tjallingk/airostation/analog-schematic.png

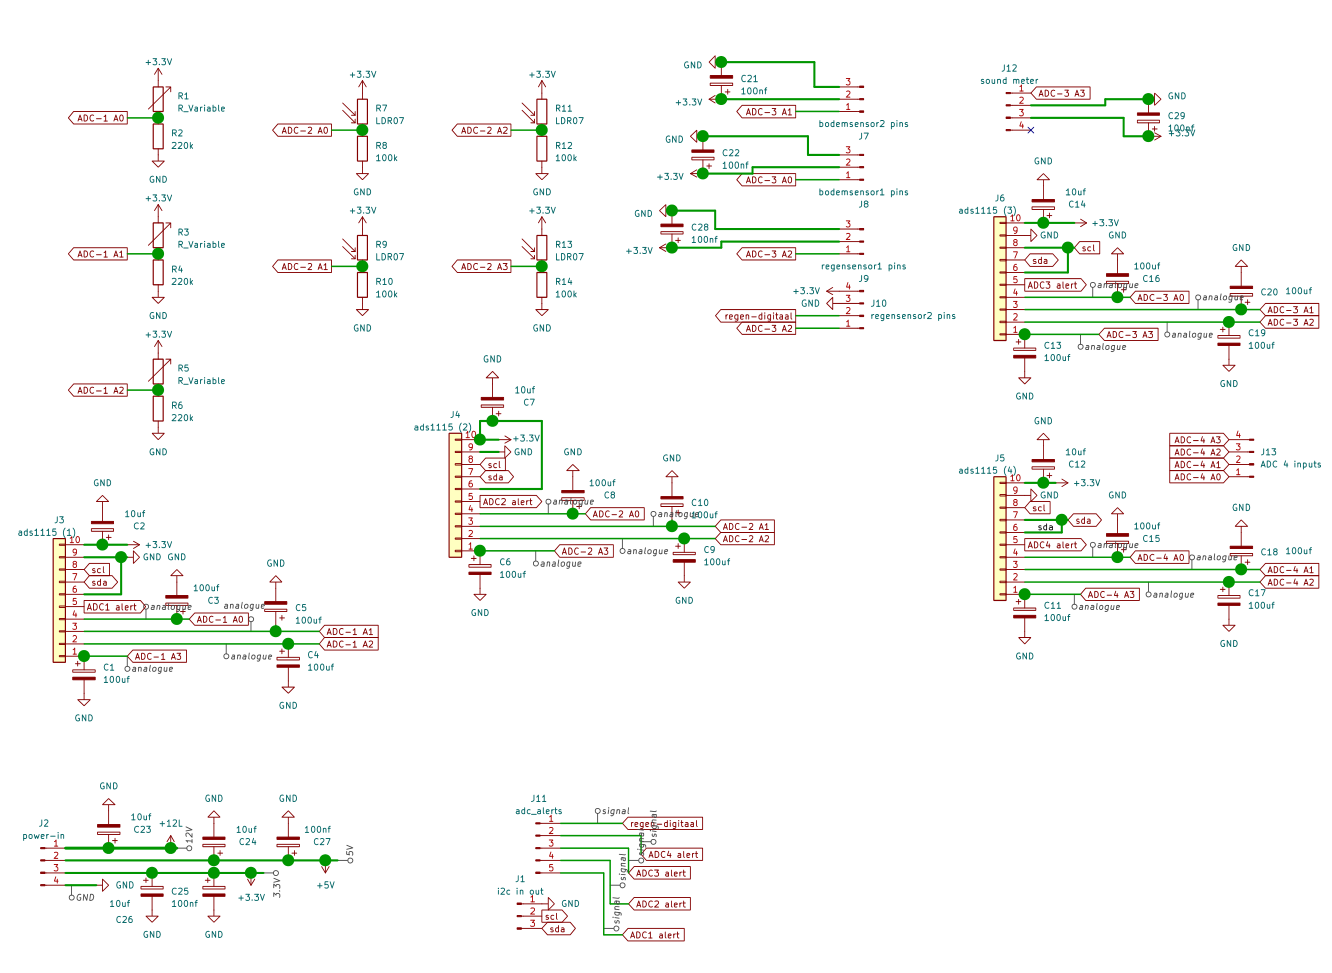
analog-schematic.png
