tjallingk/airostation/digital-main-schematic.png

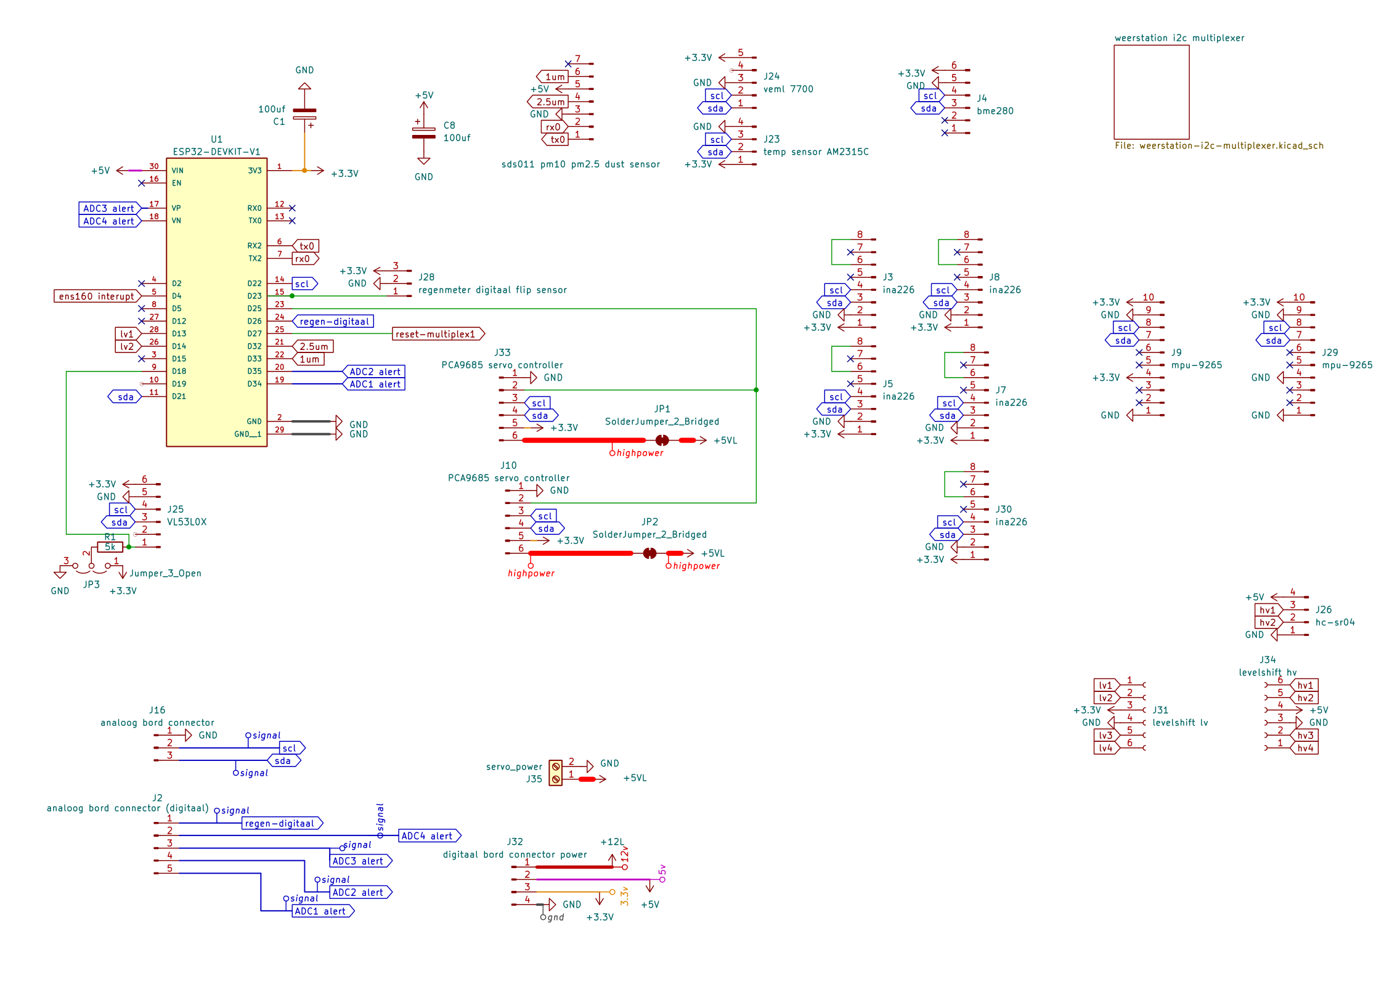
digital-main-schematic.png
