tjallingk/airostation/multiplexer-powersensor-schematic.png

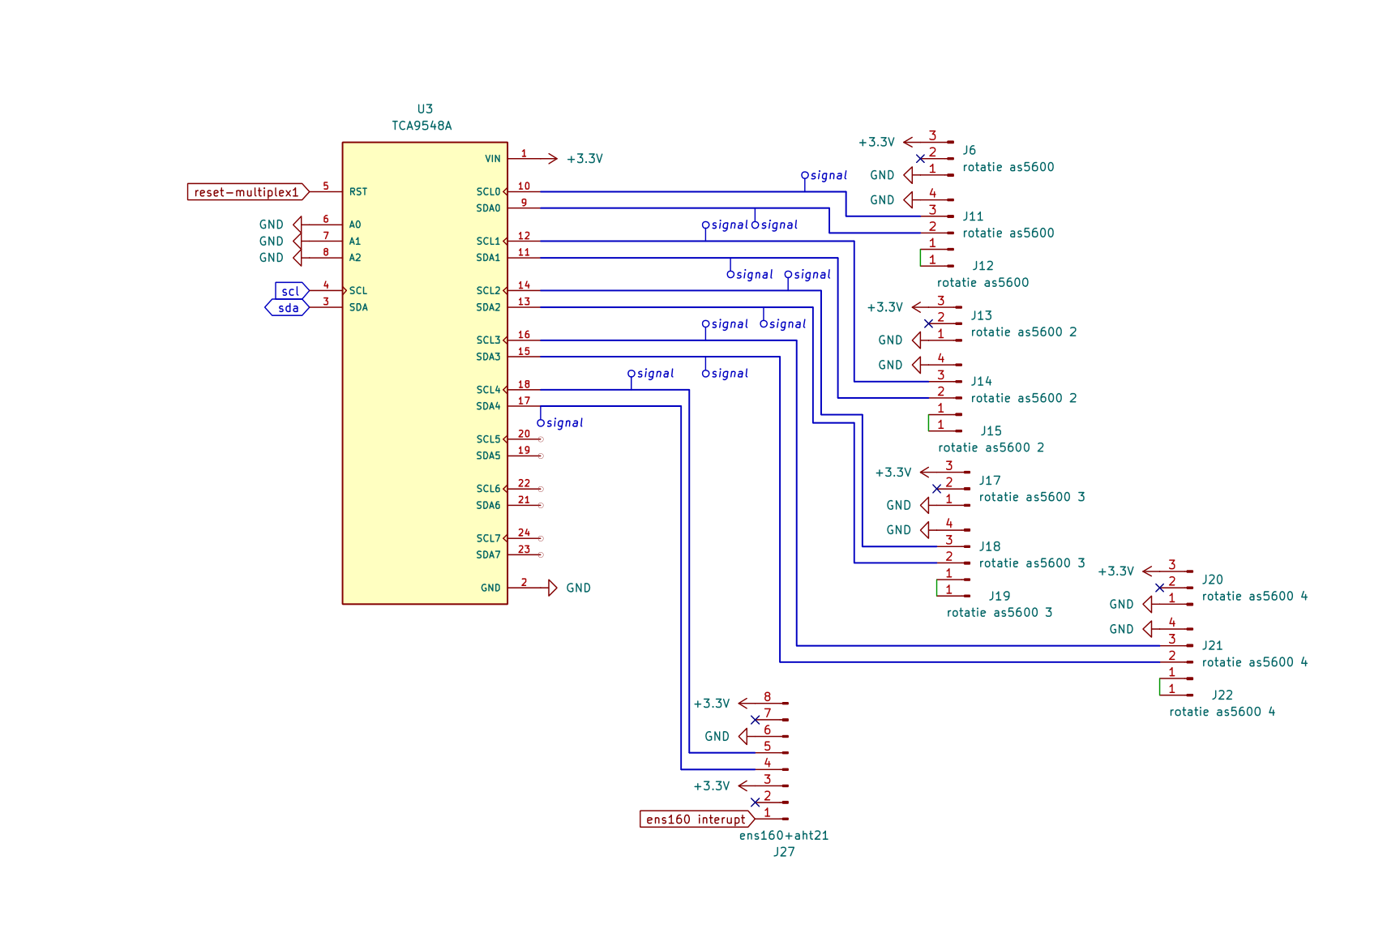
multiplexer-powersensor-schematic.png
