tjallingk/airostation/pcb images/analog-back-pcb.png

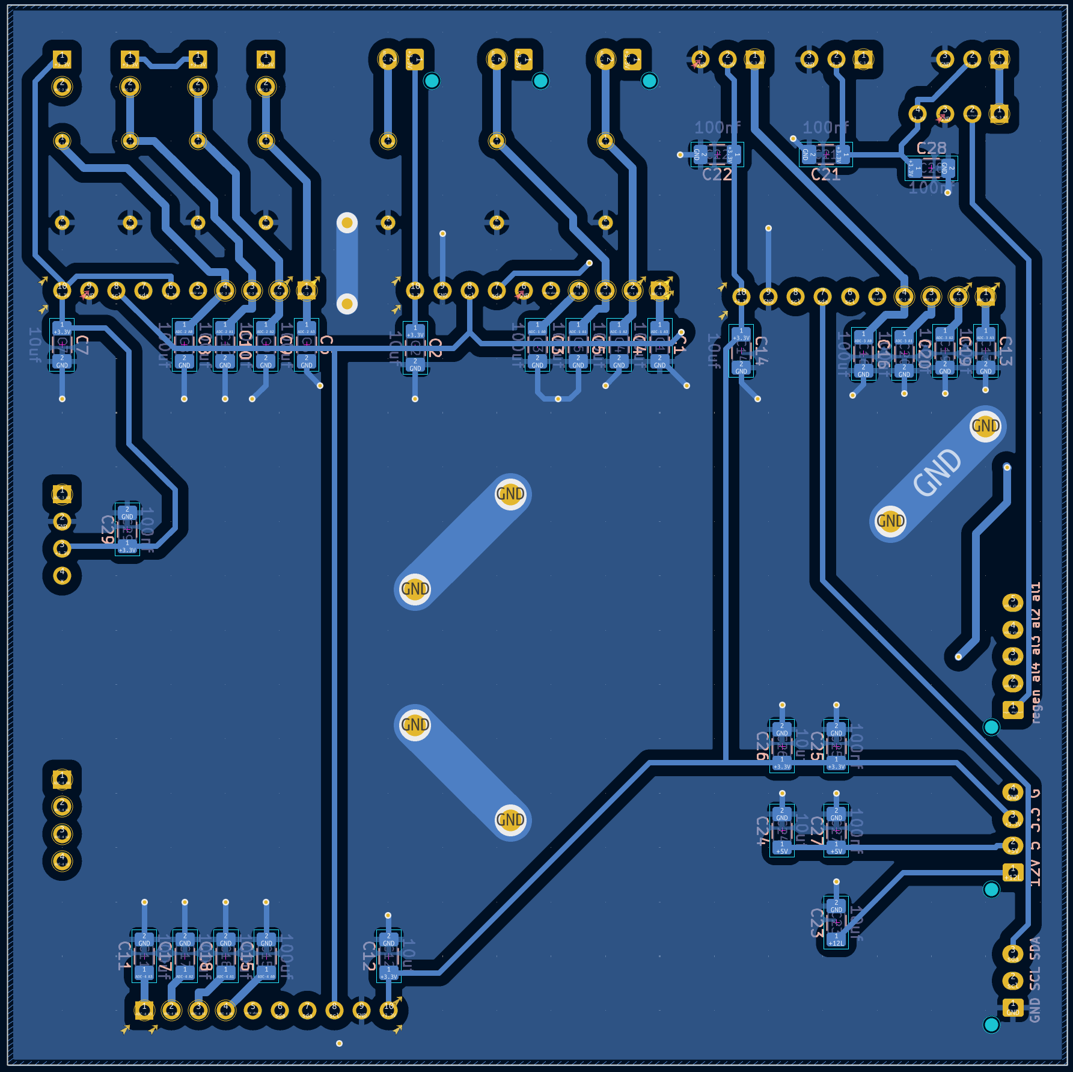
pcb images/analog-back-pcb.png
