tjallingk/airostation/pcb images/analog-front-pcb.png

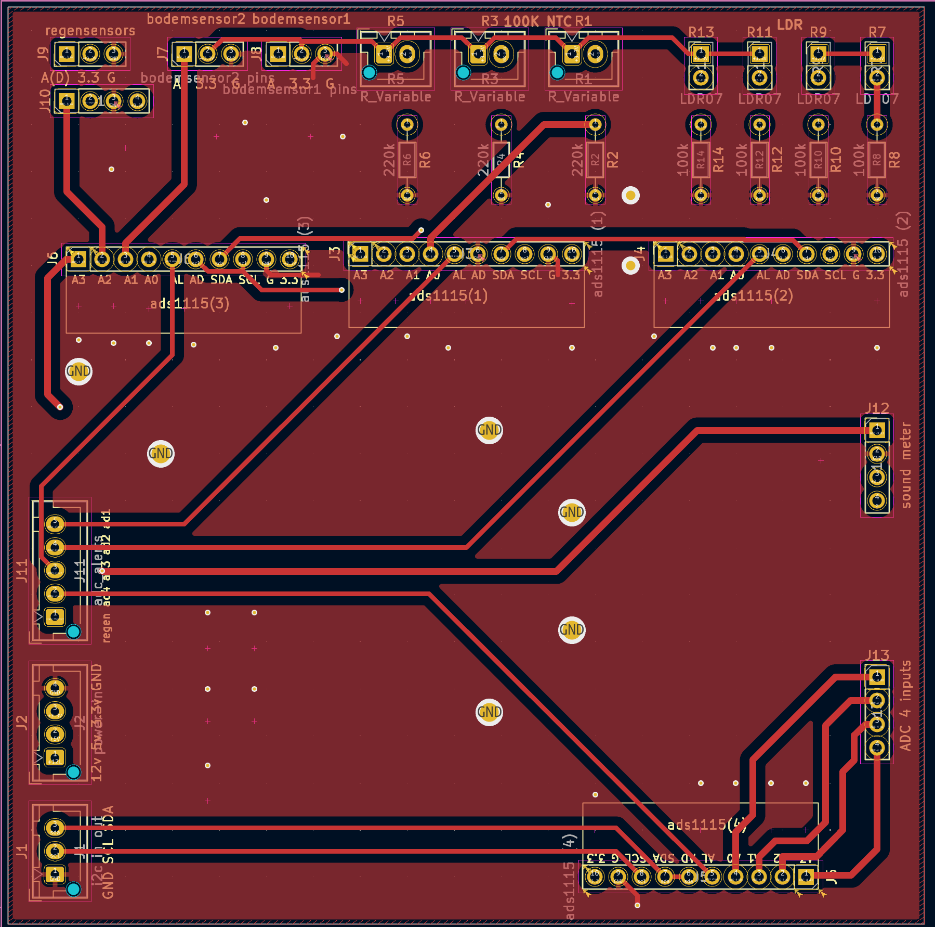
pcb images/analog-front-pcb.png
