tjallingk/airostation/pcb images/main-back-pcb.png

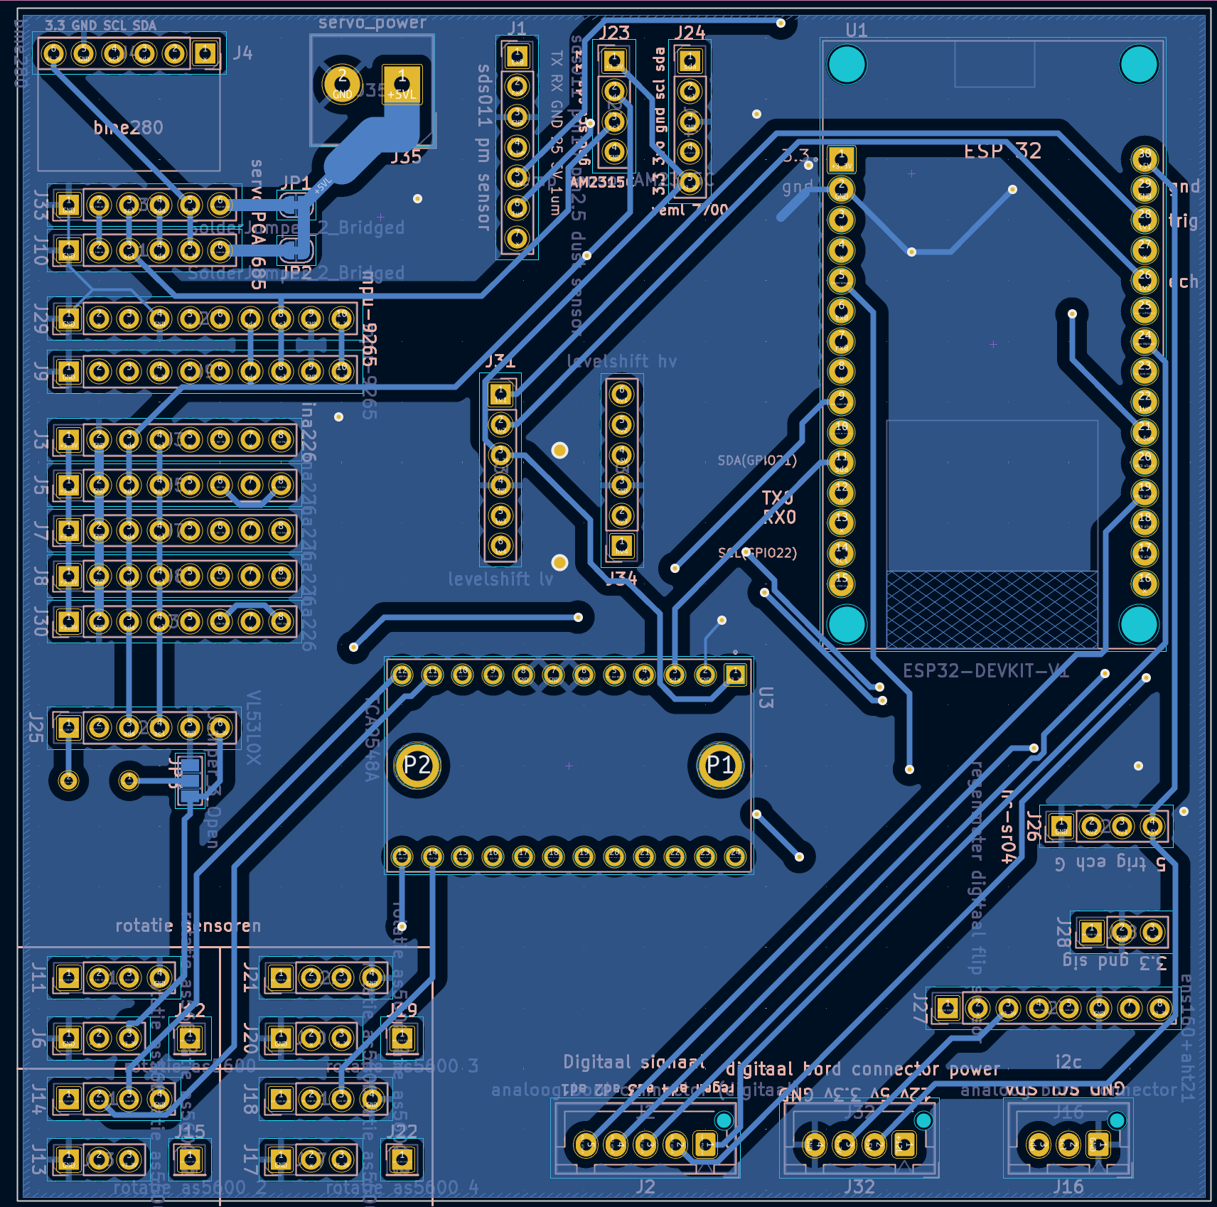
pcb images/main-back-pcb.png
