tjallingk/airostation/pcb images/main-front-pcb.png

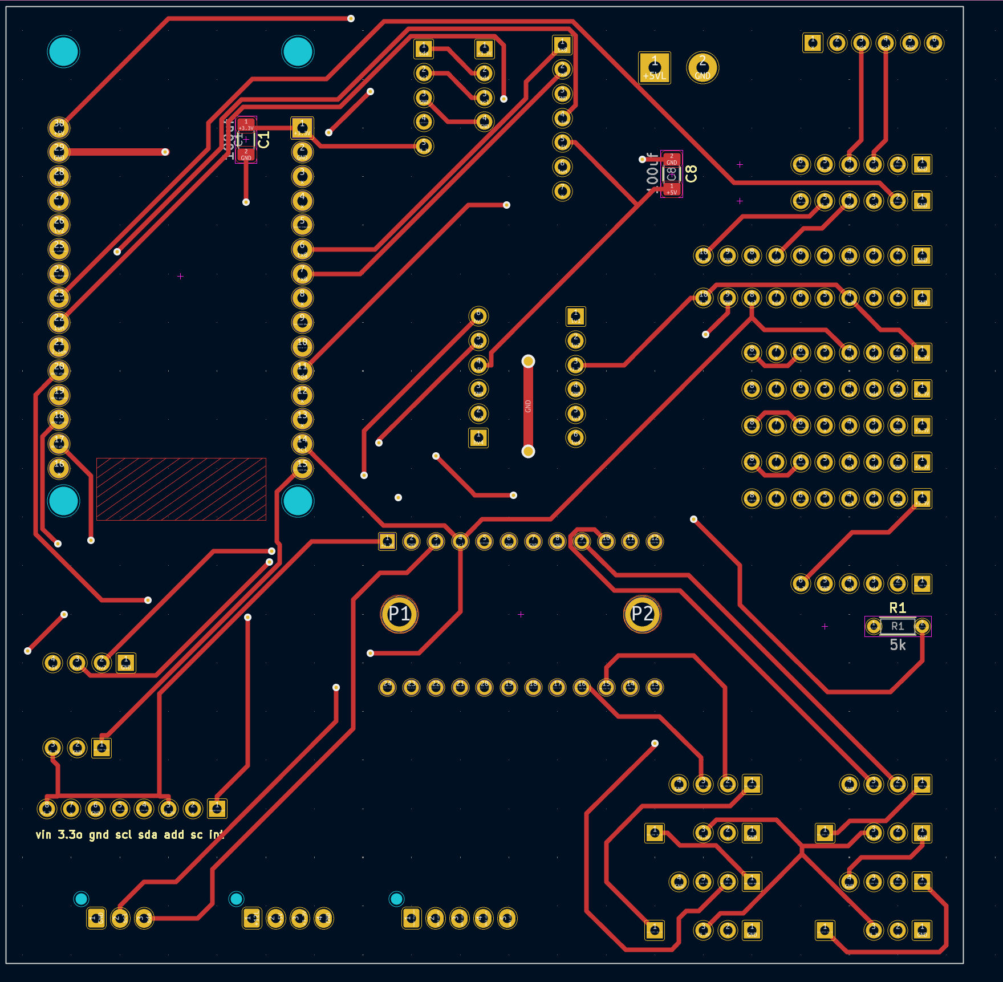
pcb images/main-front-pcb.png
