tjallingk/airostation/pcb images/power-back-pcb.png

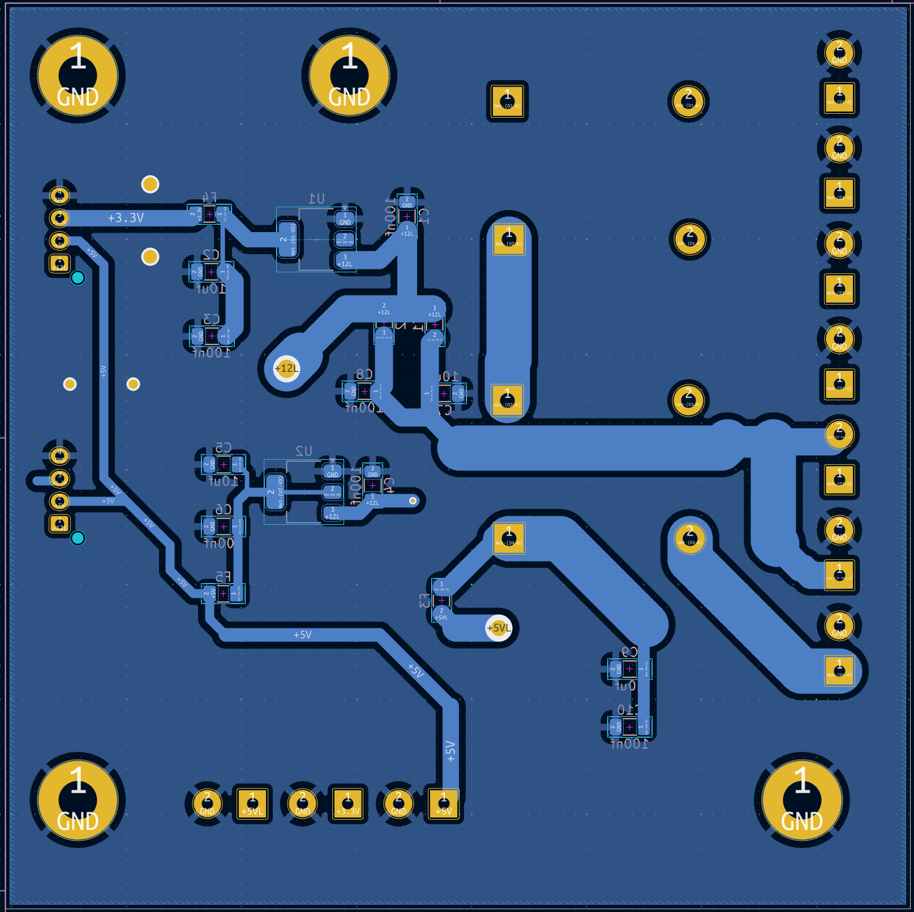
pcb images/power-back-pcb.png
