tjallingk/airostation/pcb images/power-front-pcb.png

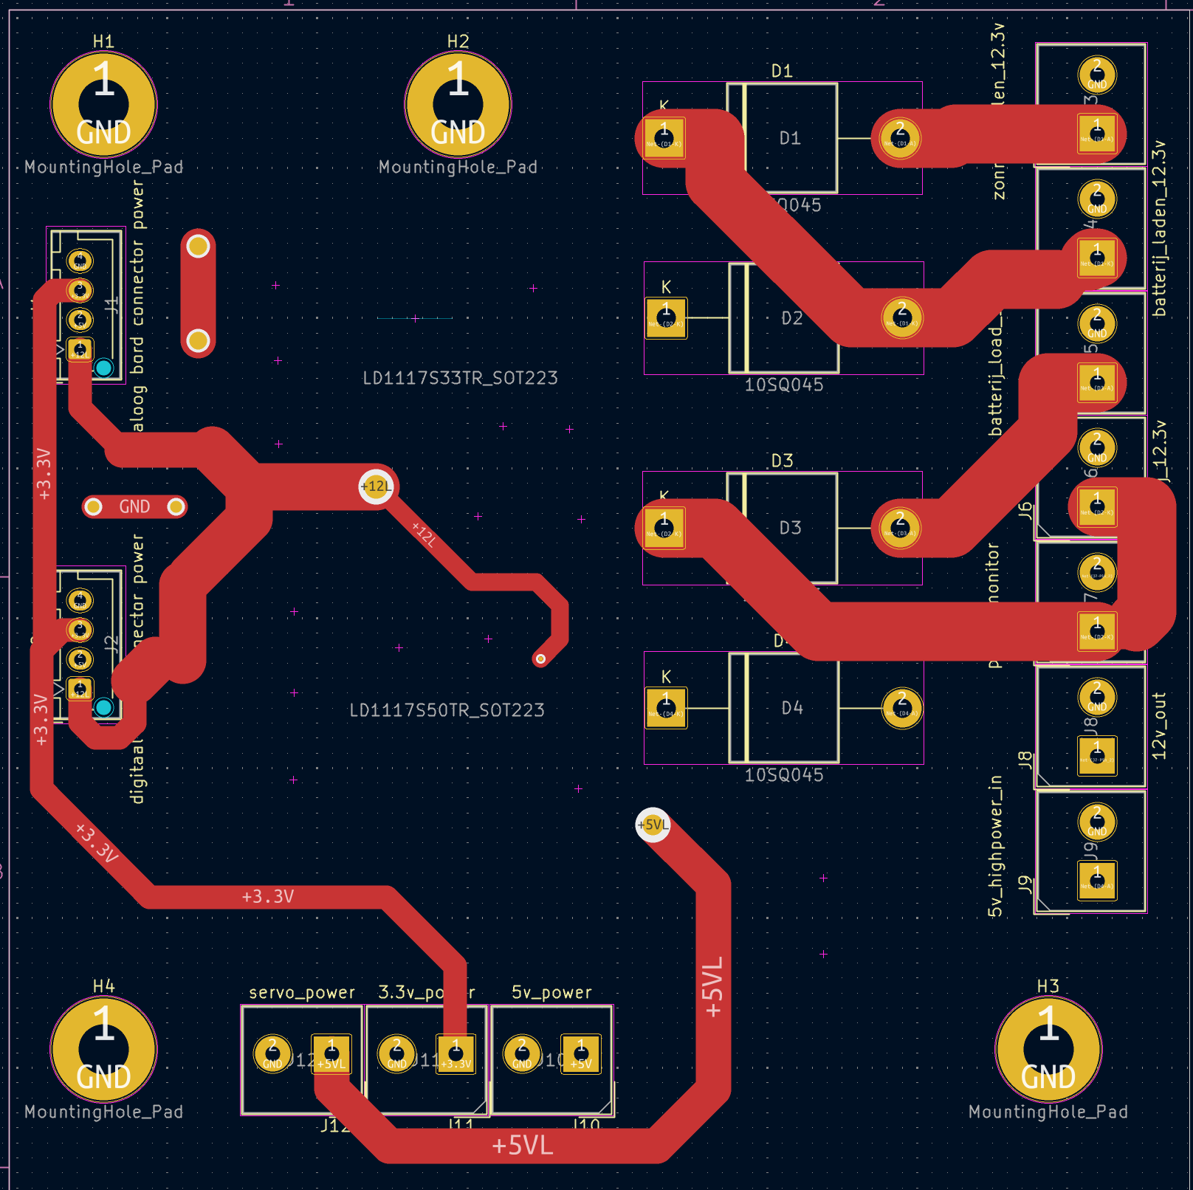
pcb images/power-front-pcb.png
