tjallingk/airostation/power-schematic.png

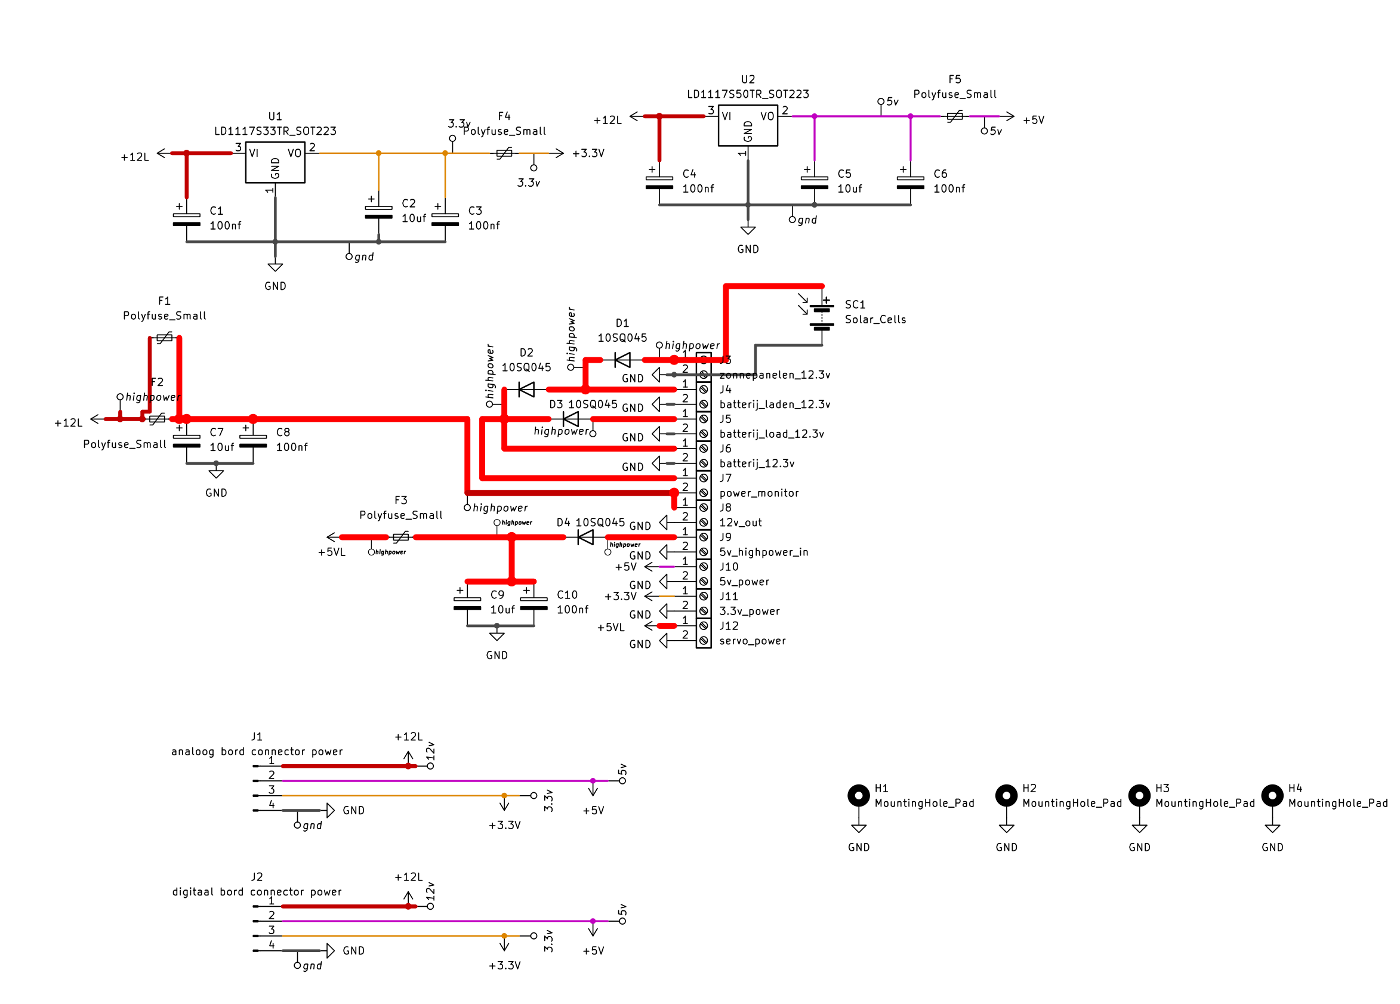
power-schematic.png
