tjallingk/airostation/pcb-files/sensoren list.ods

Components global function | part name/number | communication protocol | i2c address | function | count | importance | drawn on pcb (green is yes) | notes
power measurement | ina226 | i2c multiplexer? | 0x40,0x41,0x42,0x43,0x44,0x45,0x46,0x47,0x48,0x49, | Measure solar strength, battery charge level, and self-consumption of energy. | 5 | 3 | 6 pieces: Address is selected on the module PCB.
lux sensor | veml7700 | i2c | 0x10 | Measure the amount of sunlight. | 1 | 6
Angle sensor | mpu 9250 | i2c | 0x68,0x69 | Know the sun's position and possibly detect earthquakes? | 1 | 4 | 2 units: Only one is needed,second one possibly for earthquake detection.
Temperature sensor | AM2315C | i2c | 0x38 | Measure temperature and humidity. | 1 | 8 |  | Measured at 1.5 meters above ground level
Wind sensor | as5600 | i2c multiplexer | 0x36 | Know wind speed and direction. | 2 | 7 | 4 AS5600 | it should be measured at 10 meters high.
LDR (light-dependent resistor) | 5516 | analogue/resistor |  | Determine the sun's position along with an angle(gyro) sensor. | 4 | 4 | 4
Rain sensor |  | analogue/resistor |  | Detect rain and indicate its intensity. | 1 | 8 | 4 units, 2 types, but max 1 connected at a time.
VOC sensor | Ens160 + aht21 | i2c with multiplexer | (aht21)0x38 (ens160)0x53,0x52 | Measure air quality by detecting gases. | 1 | 7
Soil temperature sensor | ntc 100k | analogue/resistor |  | Detect ground frost and determine its depth with multiple sensors. | 3 | 6 |  | The standard depths for soil temperature measurements are 5, 10, 20, 50, and 100 cm below the surface.
Air pressure sensor | bme280 | i2c | 0x76,0x77 | Measure air pressure for weather forecasting. | 1 | 8 | Directly on the PCB. | Should be measured at mean sea level (MSL), but since that's not possible, adjustments need to be made.
Rain gauge | A3144 | digital tipping sensor |  | Measure rainfall intensity. With tipping bucket and magnet | 1 | 7
Soil moisture sensor |  | analogue |  | Measure soil moisture to determine if irrigation is needed. | 3 | 9 | 3 pieces for different places to measure the capacitive
Fine Particle sensor | sds011 | uart |  | Measure the number of fine dust particles(pm10/pm2.5) in the air. And therefor quality of air. | 1 | 7
Small solar panel |  | power short it to read |  | Measure sunlight intensity in W/m² for a panel with a surface area of 54×54 mm. | 1 | 5
Servo controller | PCA9685 | i2c | 0x40-0x7F | Control servos using fewer connectors, max 16 servos managed by 4 wires trough i2c. | 1 | 5
Distance sensor | VL53L0X | i2c | 0x52 | Snow height sensor light | 1 | 3
Distance sensor | hc sr04 | digital |  | Snow height sensor ultrasonic | 1 | 3
 |  |  |  |  | 29
ADC | ads1115 | i2c | 0x48,0x49,0x4A,0x4B | Improve measurement of analog signals with more bits. | 4 | 10
Buck converter | lm2596s |  |  | Convert 22V from the solar panel to 12V, and to 5V for servos. | 2 | 10
LDO | ld1117 |  |  | Create 5V from 12V for ESP (microcontroller). |  | 10
Servo | sg90 | pwm |  | solar tracker movement. is managed by servo controller. | 2 | 5 | The servo controller has space for 16 units.
Large solar panel |  |  |  | for off grid power with battery | 2 | 10
I2C multiplexer | TCA9548A | i2c | 0x70 tot 0x77 | Use multiple I2C sensors with the same address (e.g., AS5600). | 1 | 10
battery for backup power |  |  |  | backup for power while dark or not enough sun
bms for backup |  |  |  | backup for power while dark or not enough sun
esp32 dev board |  |  |  | controlling the whole stuff
