tjallingk/airostation/pcb-files/schematic main1.pdf

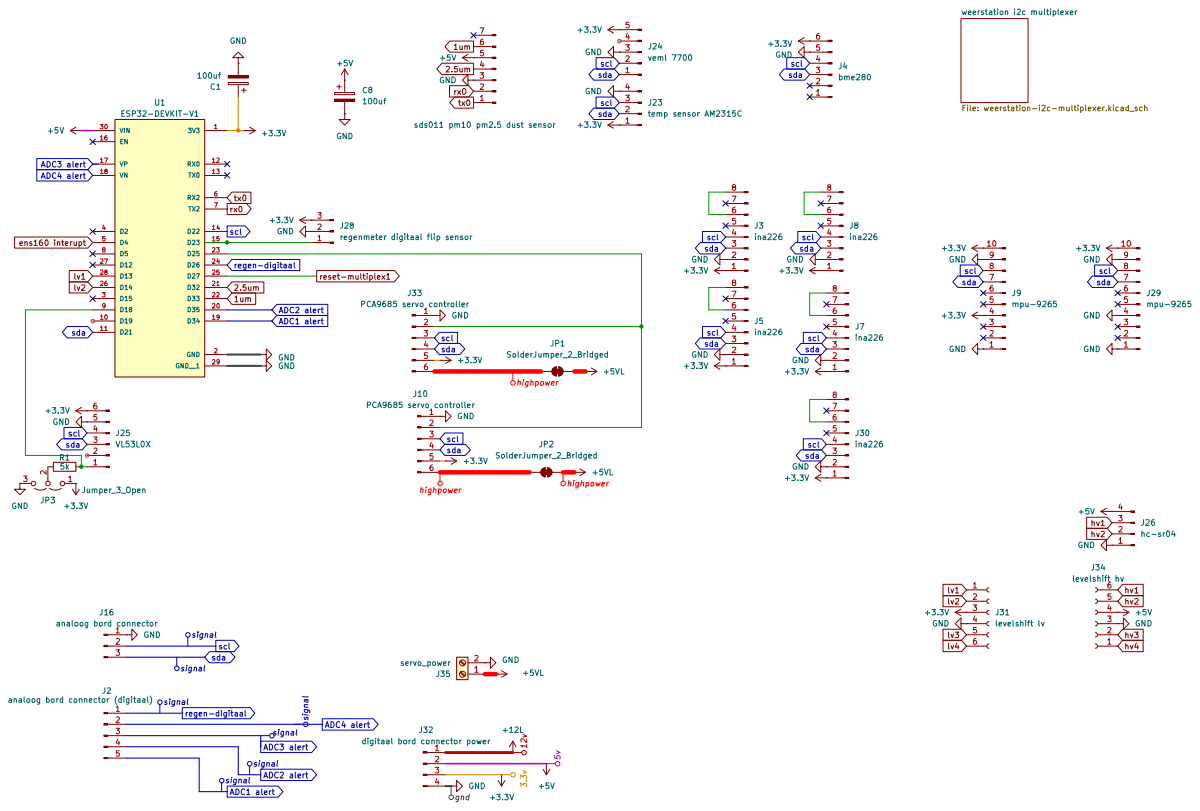
[picture p11: page 1]

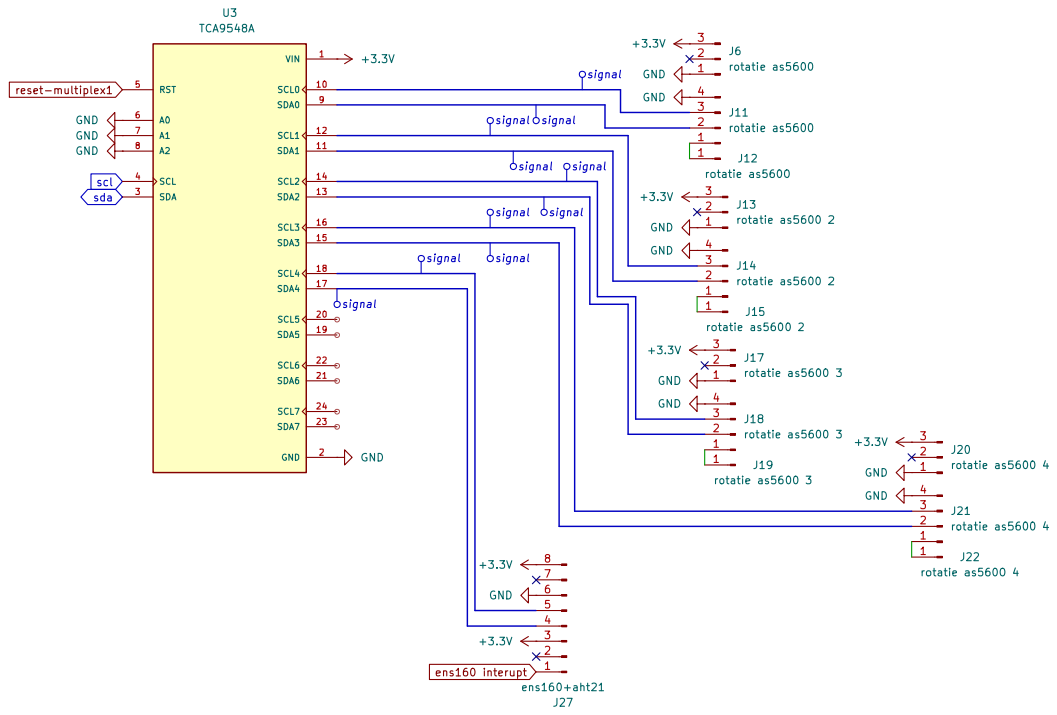
[picture p12: page 2]
