tjallingk/airostation/pcb-files/analog/schematic-analouge.pdf

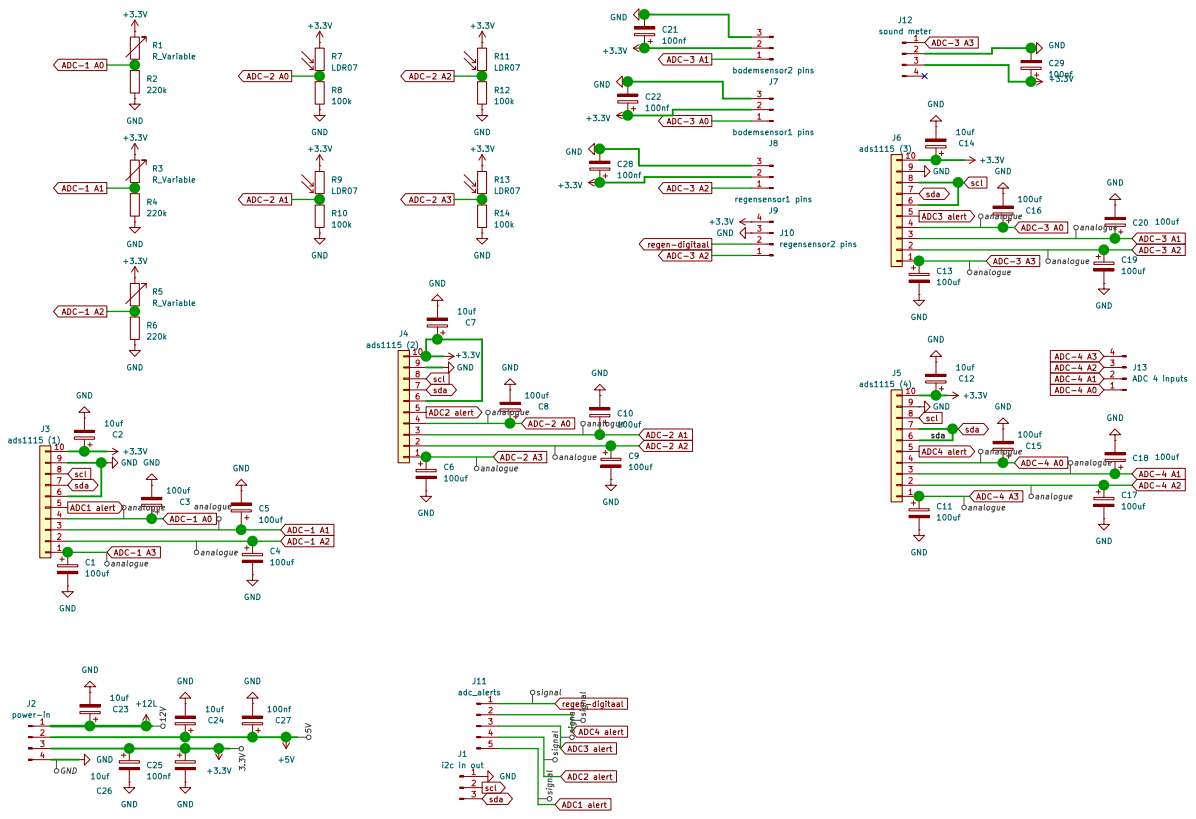
[picture p13: page 1]
