tjallingk/airostation/pcb-files/power/schematic-power.pdf

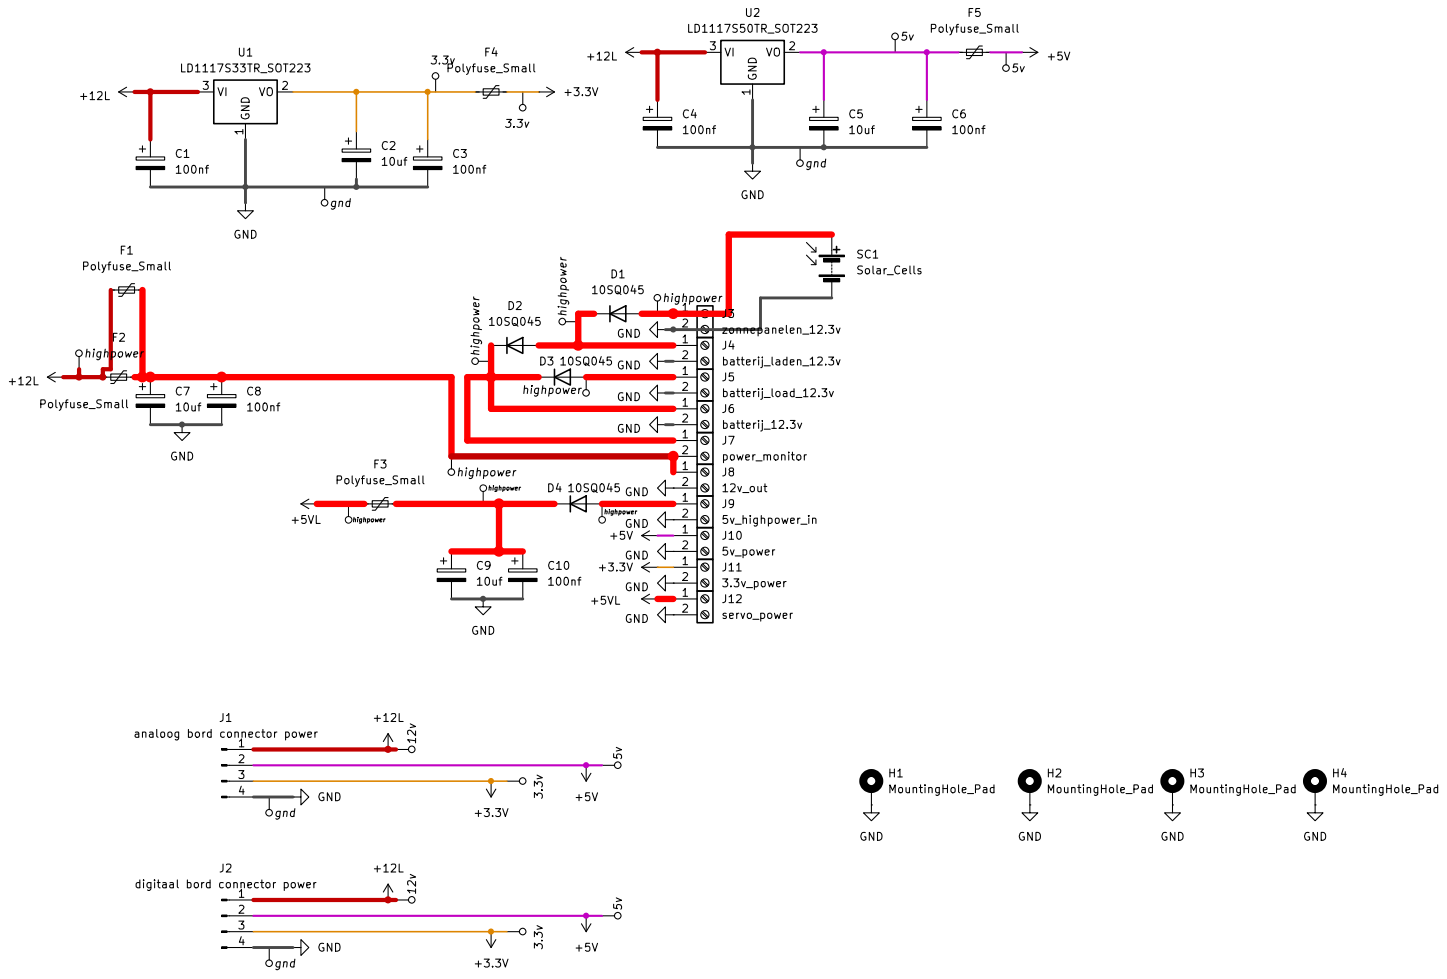
[picture p14: page 1]
