tjallingk/airostation/pcb-files/power/weerstation-power.kicad_pcb

## KiCad design pcb-files/power/weerstation-power.kicad_pcb (2024-11-19)

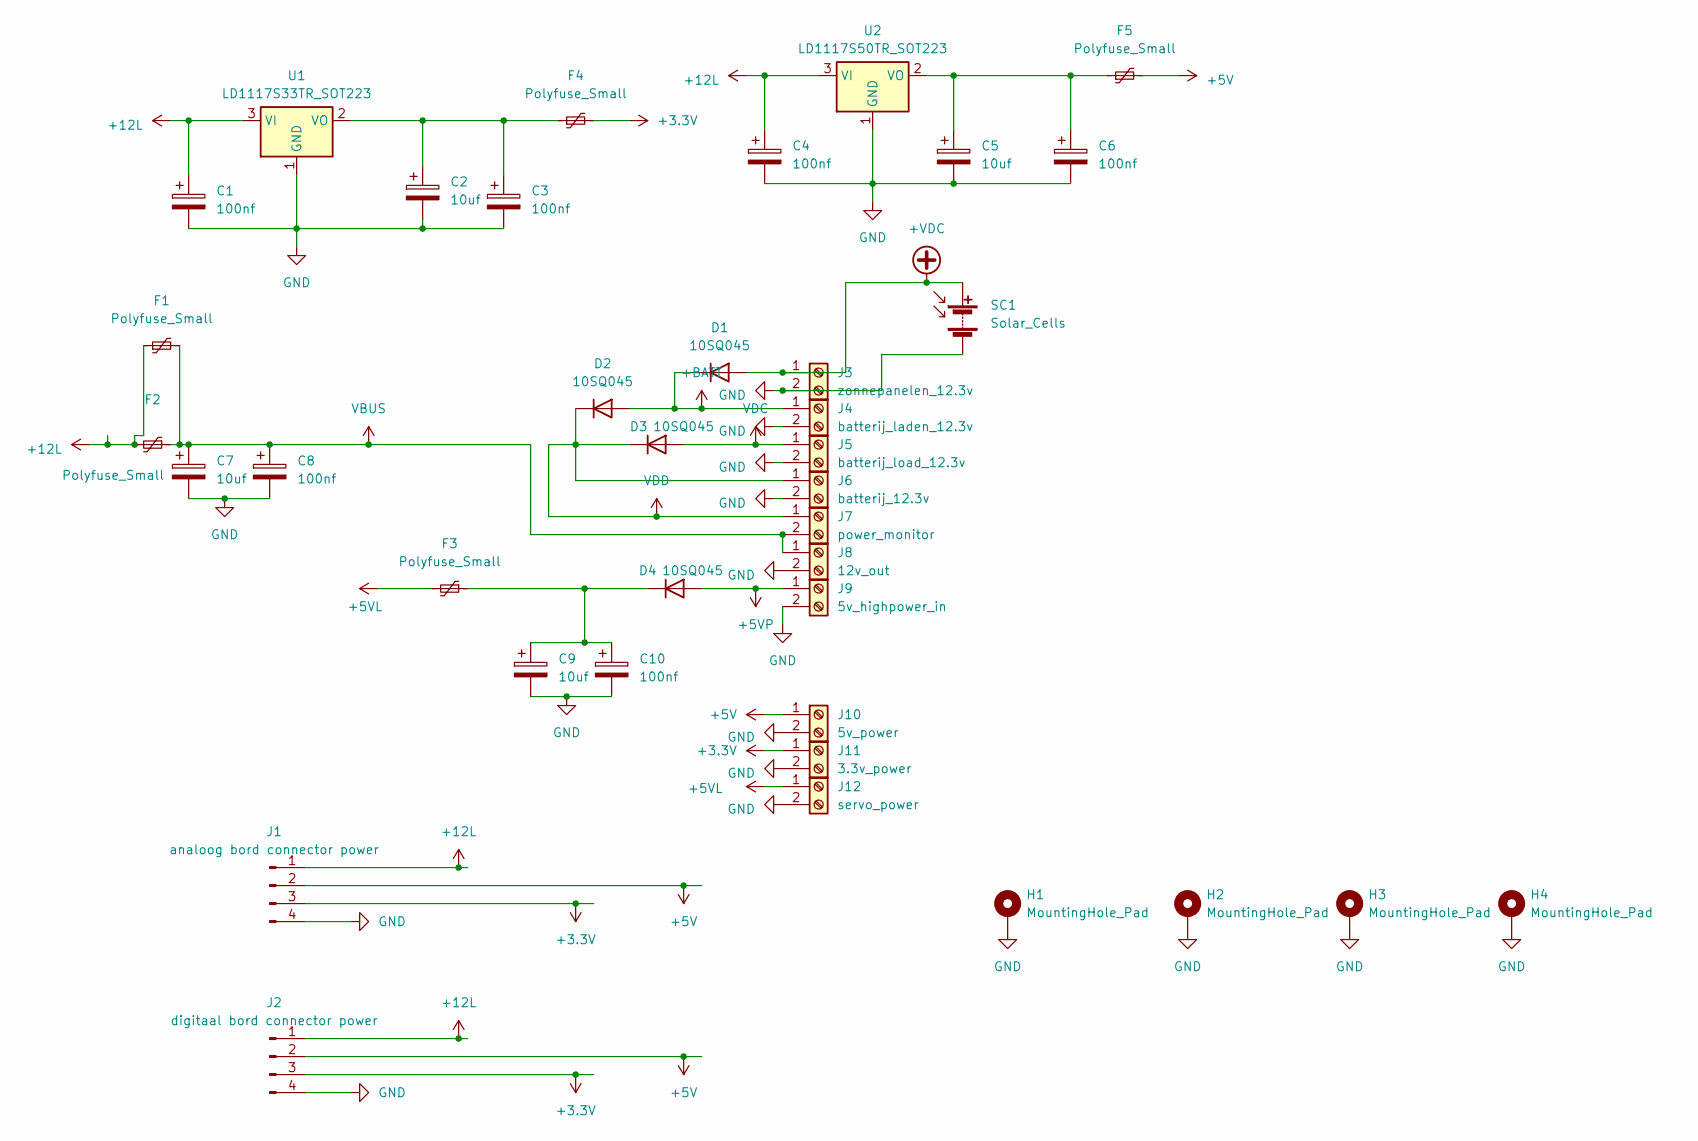
[picture p15: schematic weerstation-power.kicad_sch]

Parts:
C1, C3, C4, C6, C8, C10: 100nf; C_1206_3216Metric_Pad1.33x1.80mm_HandSolder
C2, C5, C7, C9: 10uf; C_1206_3216Metric_Pad1.33x1.80mm_HandSolder
D1, D2, D3, D4: 10SQ045; D_P600_R-6_P20.00mm_Horizontal
F1, F2, F3, F4, F5: Polyfuse_Small; Fuse_12060hole_3216Metric_Pad1.42x1.75mm_HandSolder
H1, H2, H3, H4: MountingHole_Pad; MountingHole_4.3mm_M4_Pad
J1: analoog bord connector power; JST_XH_B4B-XH-AM_1x04_P2.50mm_Vertical
J2: digitaal bord connector power; JST_XH_B4B-XH-AM_1x04_P2.50mm_Vertical
J3: zonnepanelen_12.3v; Altech_AK100_1x02_P5.00mm
J4: batterij_laden_12.3v; Altech_AK100_1x02_P5.00mm
J5: batterij_load_12.3v; Altech_AK100_1x02_P5.00mm
J6: batterij_12.3v; Altech_AK100_1x02_P5.00mm
J7: power_monitor; Altech_AK100_1x02_P5.00mm
J8: 12v_out; Altech_AK100_1x02_P5.00mm
J9: 5v_highpower_in; Altech_AK100_1x02_P5.00mm
J10: 5v_power; Altech_AK100_1x02_P5.00mm
J11: 3.3v_power; Altech_AK100_1x02_P5.00mm
J12: servo_power; Altech_AK100_1x02_P5.00mm
SC1: Solar_Cells
U1: LD1117S33TR_SOT223; SOT-223-3_TabPin2
U2: LD1117S50TR_SOT223; SOT-223-3_TabPin2

Connections:
+3.3V: F4.2, J1.3, J2.3, J11.1
+5V: F5.2, J1.2, J2.2, J10.1
+5VL: F3.2, J12.1
+5VP: D4.2 (A), J9.1
+12L: C1.1, C4.1, F1.1, F2.2, J1.1, J2.1, U1.3 (VI), U2.3 (VI)
+BATT: D1.1 (K), D2.2 (A), J4.1
+VDC: D1.2 (A), J3.1, SC1.1 (+)
GND: C1.2, C2.2, C3.2, C4.2, C5.2, C6.2, C7.2, C8.2, C9.2, C10.2, H1.1, H2.1, H3.1, H4.1, J1.4, J2.4, J3.2, J4.2, J5.2, J6.2, J8.2, J9.2, J10.2, J11.2, J12.2, SC1.2 (-), U1.1 (GND), U2.1 (GND)
unnamed: C9.1, C10.1, D4.1 (K), F3.1
unnamed: C2.1, C3.1, F4.1, U1.2 (VO)
unnamed: C5.1, C6.1, F5.1, U2.2 (VO)
VBUS: C7.1, C8.1, F1.2, F2.1, J7.2, J8.1
VDC: D3.2 (A), J5.1
VDD: D2.1 (K), D3.1 (K), J6.1, J7.1

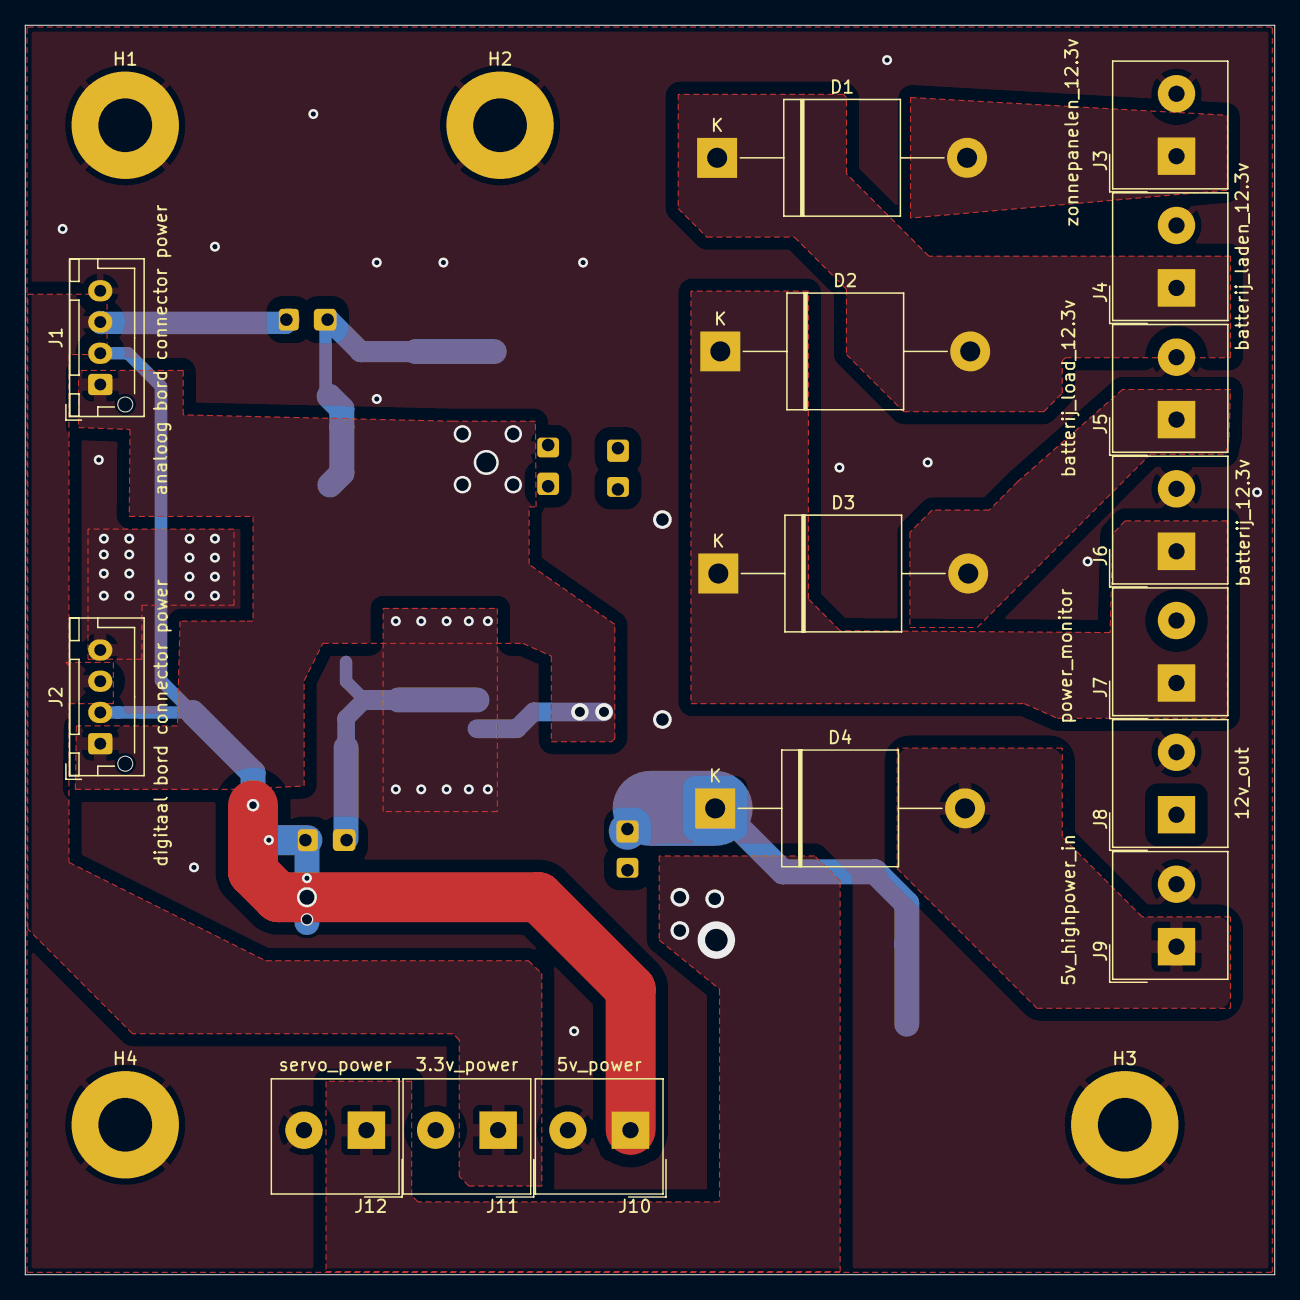
[picture p16: board weerstation-power.kicad_pcb from above]

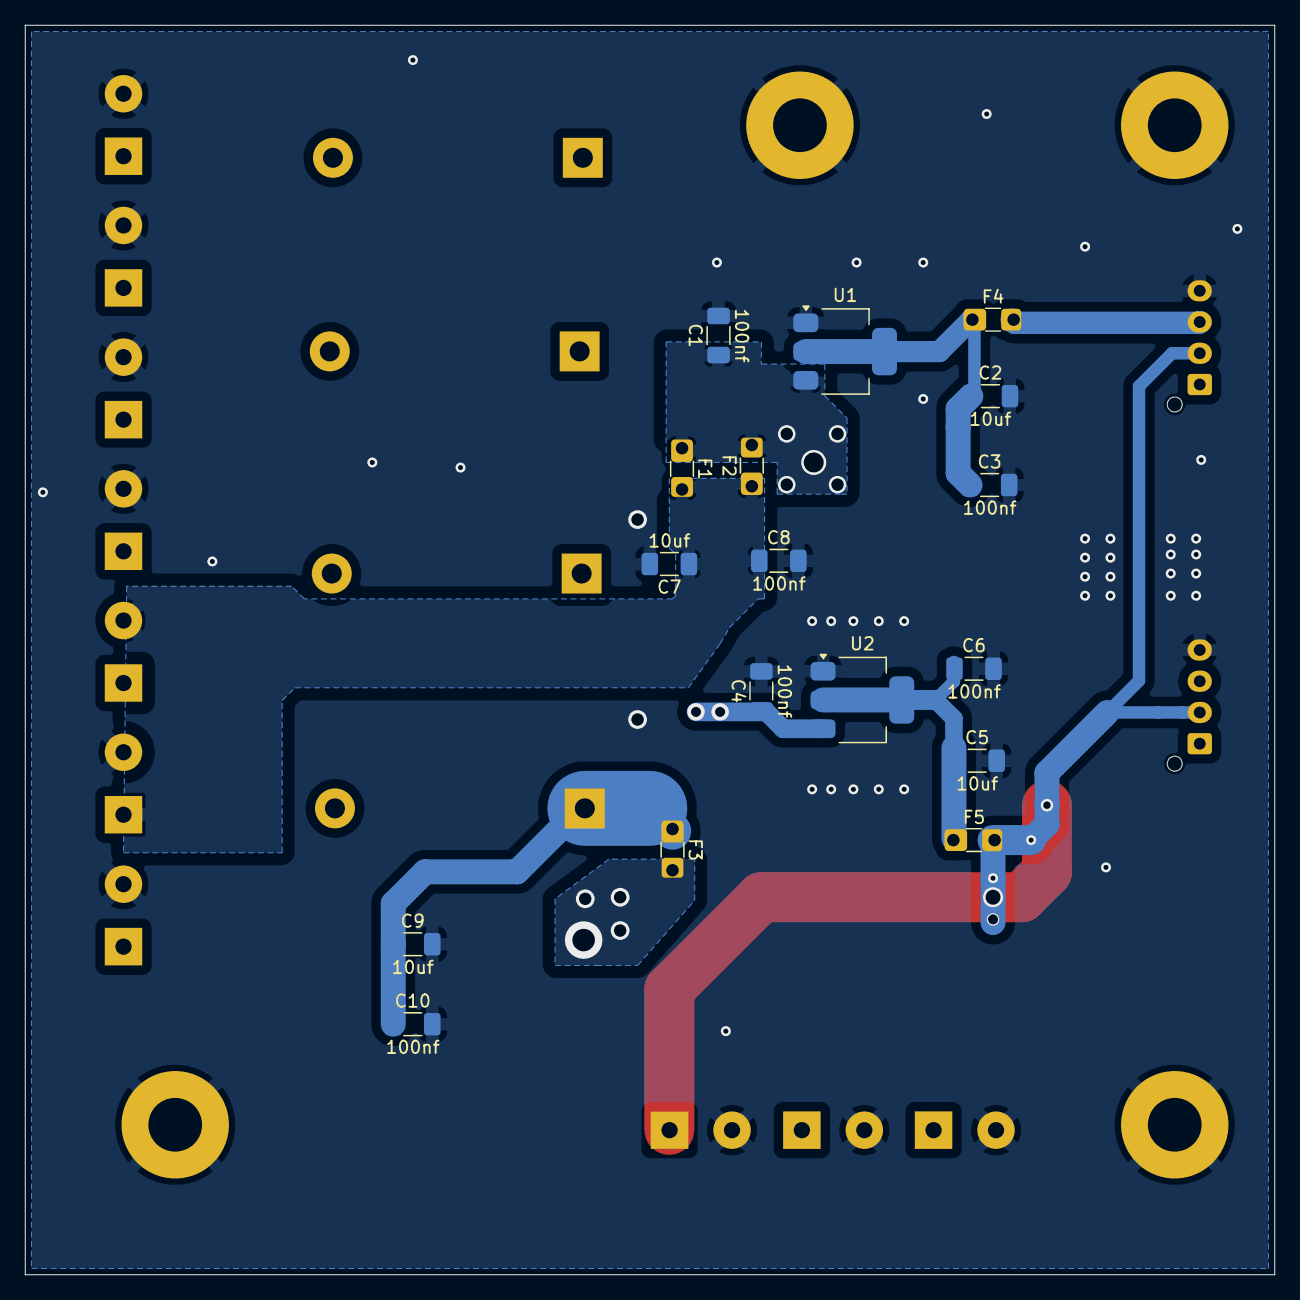
[picture p17: board weerstation-power.kicad_pcb from below]

Board: 2 copper layers, 100.0 x 100.0 mm, 37 parts (17 on the bottom side), 14 nets.
