tjallingk/airostation/pcb-files/main-digital/weerstation-main.kicad_pcb

## KiCad design pcb-files/main-digital/weerstation-main.kicad_pcb (2024-11-19)

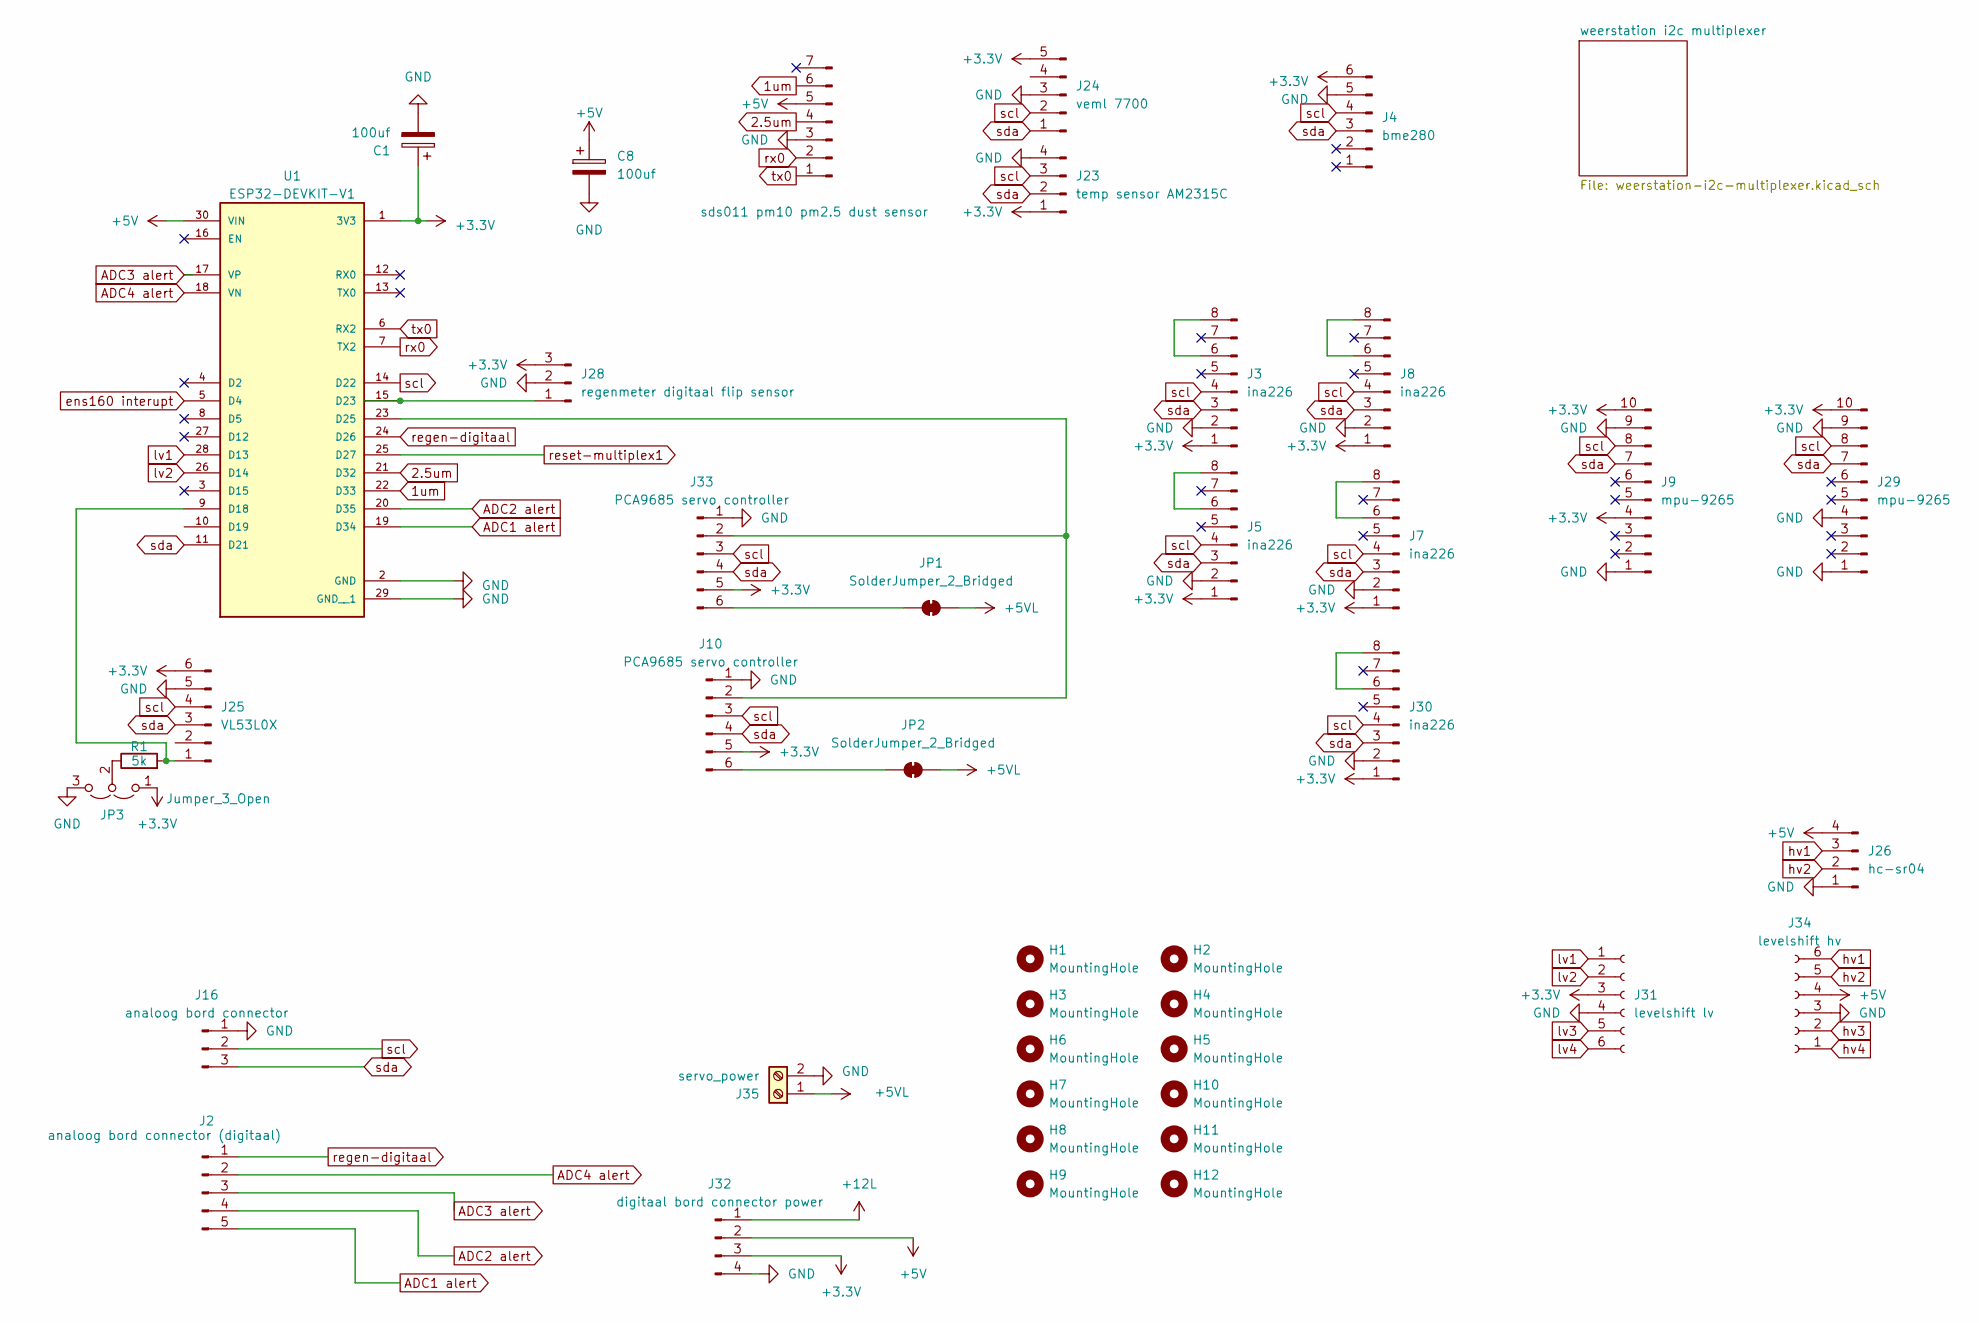
[picture p18: schematic weerstation-main.kicad_sch]

Parts:
C1, C8: 100uf; C_1206_3216Metric_Pad1.33x1.80mm_HandSolder
H1, H2, H3, H4, H5, H6, H7, H8, H9, H10, H11, H12: MountingHole; MountingHole_long
J1: sds011 pm10 pm2.5 dust sensor; PinHeader_1x07_P2.54mm_Vertical
J2: analoog bord connector (digitaal); JST_XH_B5B-XH-AM_1x05_P2.50mm_Vertical
J3, J5, J7, J8, J30: ina226; PinHeader_1x08_P2.54mm_Vertical
J4: bme280; PinSocket_1x06_P2.54mm_Vertical
J9, J29: mpu-9265; PinHeader_1x10_P2.54mm_Vertical
J10, J33: PCA9685 servo controller; PinHeader_1x06_P2.54mm_Vertical
J16: analoog bord connector; JST_XH_B3B-XH-AM_1x03_P2.50mm_Vertical
J23: temp sensor AM2315C; PinHeader_1x04_P2.54mm_Vertical
J24: veml 7700; PinHeader_1x05_P2.54mm_Vertical
J25: VL53L0X; PinSocket_1x06_P2.54mm_Vertical
J26: hc-sr04; PinHeader_1x04_P2.54mm_Vertical
J28: regenmeter digitaal flip sensor; PinHeader_1x03_P2.54mm_Vertical
J31: levelshift lv; PinSocket_1x06_P2.54mm_Vertical
J32: digitaal bord connector power; JST_XH_B4B-XH-AM_1x04_P2.50mm_Vertical
J34: levelshift hv; PinSocket_1x06_P2.54mm_Vertical
J35: servo_power; Altech_AK100_1x02_P5.00mm
JP1, JP2: SolderJumper_2_Bridged; SolderJumper-2_P1.3mm_Bridged_RoundedPad1.0x1.5mm
JP3: Jumper_3_Open; SolderJumper-3_P1.3mm_Open_Pad1.0x1.5mm
R1: 5k; R_Axial_DIN0204_L3.6mm_D1.6mm_P5.08mm_Horizontal
U1: ESP32-DEVKIT-V1; MODULE_ESP32_DEVKIT_V1; PARTREV N/A

Connections:
1um: J1.6, U1.22 (D33)
2.5um: J1.4, U1.21 (D32)
+3.3V: C1.1, J3.1, J4.6, J5.1, J7.1, J8.1, J9.4, J9.10, J10.5, J23.1, J24.5, J25.6, J28.3, J29.10, J30.1, J31.3, J32.3, J33.5, JP3.1 (A), U1.1 (3V3); also elsewhere on the board
+5V: C8.1, J1.5, J26.4, J32.2, J34.4, U1.30 (VIN)
+5VL: J35.1, JP1.2 (B), JP2.2 (B)
+12L: J32.1
ADC1 alert: J2.5, U1.19 (D34)
ADC2 alert: J2.4, U1.20 (D35)
ADC3 alert: J2.3, U1.17 (VP)
ADC4 alert: J2.2, U1.18 (VN)
GND: C1.2, C8.2, J1.3, J3.2, J4.5, J5.2, J7.2, J8.2, J9.1, J9.9, J10.1, J16.1, J23.4, J24.3, J25.5, J26.1, J28.2, J29.1, J29.4, J29.9, J30.2, J31.4, J32.4, J33.1, J34.3, J35.2, JP3.3 (B), U1.2 (GND), U1.29 (GND__1); also elsewhere on the board
unnamed: J3.6, J3.8
unnamed: J5.6, J5.8
unnamed: J7.6, J7.8
unnamed: J8.6, J8.8
unnamed: J10.2, J33.2, U1.23 (D25)
unnamed: J10.6, JP2.1 (A)
unnamed: J25.1, R1.2, U1.9 (D18)
unnamed: J28.1, U1.15 (D23)
unnamed: J30.6, J30.8
unnamed: J33.6, JP1.1 (A)
unnamed: JP3.2 (C), R1.1
ens160 interupt: U1.5 (D4); also elsewhere on the board
hv1: J26.3, J34.6
hv2: J26.2, J34.5
hv3: J34.2
hv4: J34.1
lv1: J31.1, U1.28 (D13)
lv2: J31.2, U1.26 (D14)
lv3: J31.5
lv4: J31.6
regen-digitaal: J2.1, U1.24 (D26)
reset-multiplex1: U1.25 (D27)
rx0: J1.2, U1.7 (TX2)
scl: J3.4, J4.4, J5.4, J7.4, J8.4, J9.8, J10.3, J16.2, J23.3, J24.2, J25.4, J29.8, J30.4, J33.3, U1.14 (D22); also elsewhere on the board
sda: J3.3, J4.3, J5.3, J7.3, J8.3, J9.7, J10.4, J16.3, J23.2, J24.1, J25.3, J29.7, J30.3, J33.4, U1.11 (D21); also elsewhere on the board
tx0: J1.1, U1.6 (RX2)

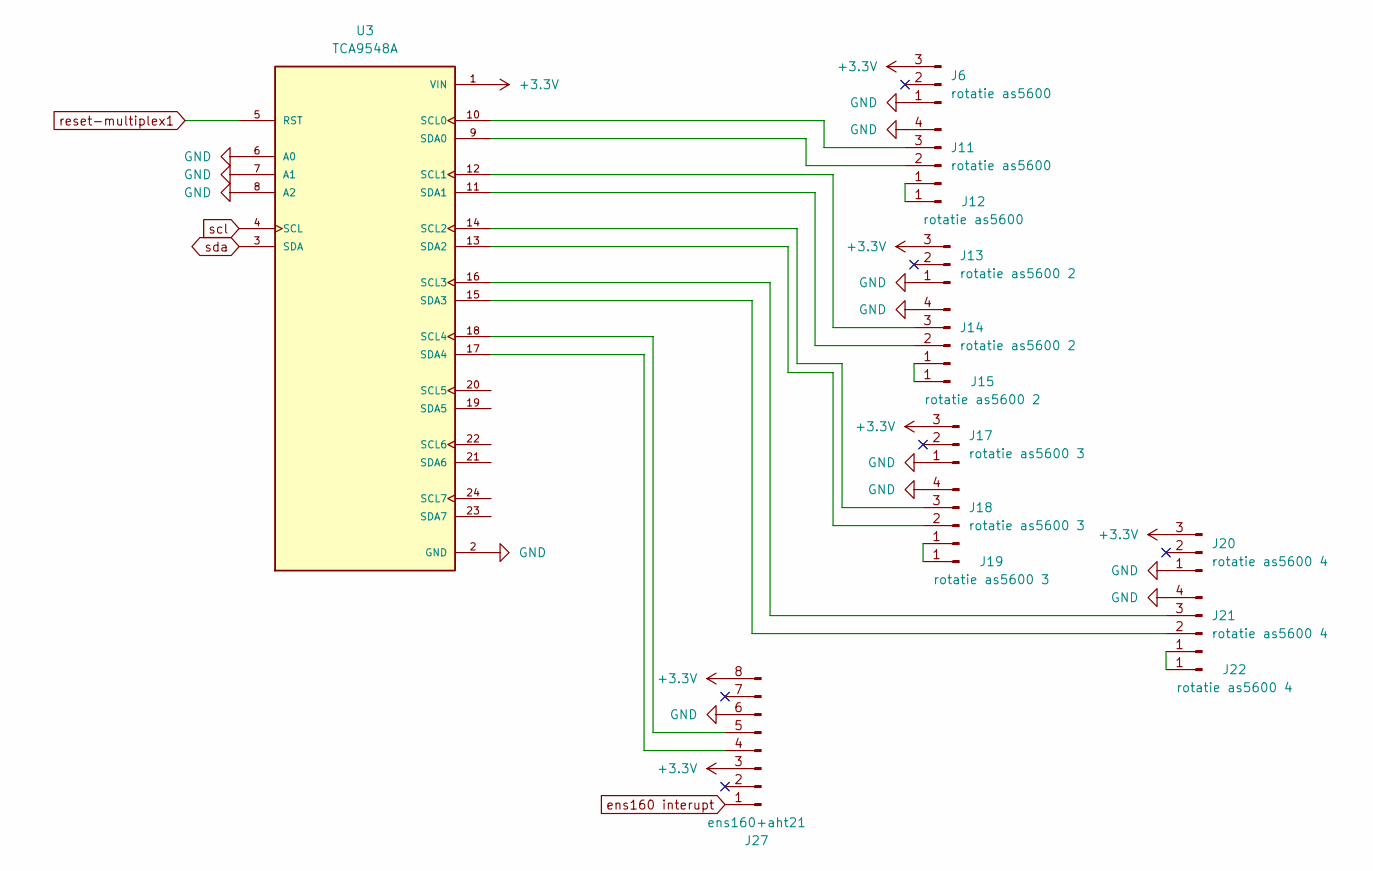
[picture p19: schematic weerstation-i2c-multiplexer.kicad_sch]

Parts:
J6: rotatie as5600; PinHeader_1x03_P2.54mm_Vertical
J11: rotatie as5600; PinHeader_1x04_P2.54mm_Vertical
J12: rotatie as5600; PinHeader_1x01_P2.54mm_Vertical
J13: rotatie as5600 2; PinHeader_1x03_P2.54mm_Vertical
J14: rotatie as5600 2; PinHeader_1x04_P2.54mm_Vertical
J15: rotatie as5600 2; PinHeader_1x01_P2.54mm_Vertical
J17: rotatie as5600 3; PinHeader_1x03_P2.54mm_Vertical
J18: rotatie as5600 3; PinHeader_1x04_P2.54mm_Vertical
J19: rotatie as5600 3; PinHeader_1x01_P2.54mm_Vertical
J20: rotatie as5600 4; PinHeader_1x03_P2.54mm_Vertical
J21: rotatie as5600 4; PinHeader_1x04_P2.54mm_Vertical
J22: rotatie as5600 4; PinHeader_1x01_P2.54mm_Vertical
J27: ens160+aht21; PinHeader_1x08_P2.54mm_Vertical
U3: TCA9548A; MODULE_2717; PARTREV Sep 11, 2015

Connections:
+3.3V: J6.3, J13.3, J17.3, J20.3, J27.3, J27.8, U3.1 (VIN); also elsewhere on the board
GND: J6.1, J11.4, J13.1, J14.4, J17.1, J18.4, J20.1, J21.4, J27.6, U3.2 (GND), U3.6 (A0), U3.7 (A1), U3.8 (A2); also elsewhere on the board
unnamed: J11.1, J12.1
unnamed: J11.2, U3.9 (SDA0)
unnamed: J11.3, U3.10 (SCL0)
unnamed: J14.1, J15.1
unnamed: J14.2, U3.11 (SDA1)
unnamed: J14.3, U3.12 (SCL1)
unnamed: J18.1, J19.1
unnamed: J18.2, U3.13 (SDA2)
unnamed: J18.3, U3.14 (SCL2)
unnamed: J21.1, J22.1
unnamed: J21.2, U3.15 (SDA3)
unnamed: J21.3, U3.16 (SCL3)
unnamed: J27.4, U3.17 (SDA4)
unnamed: J27.5, U3.18 (SCL4)
ens160 interupt: J27.1; also elsewhere on the board
scl: U3.4 (SCL); also elsewhere on the board
sda: U3.3 (SDA); also elsewhere on the board

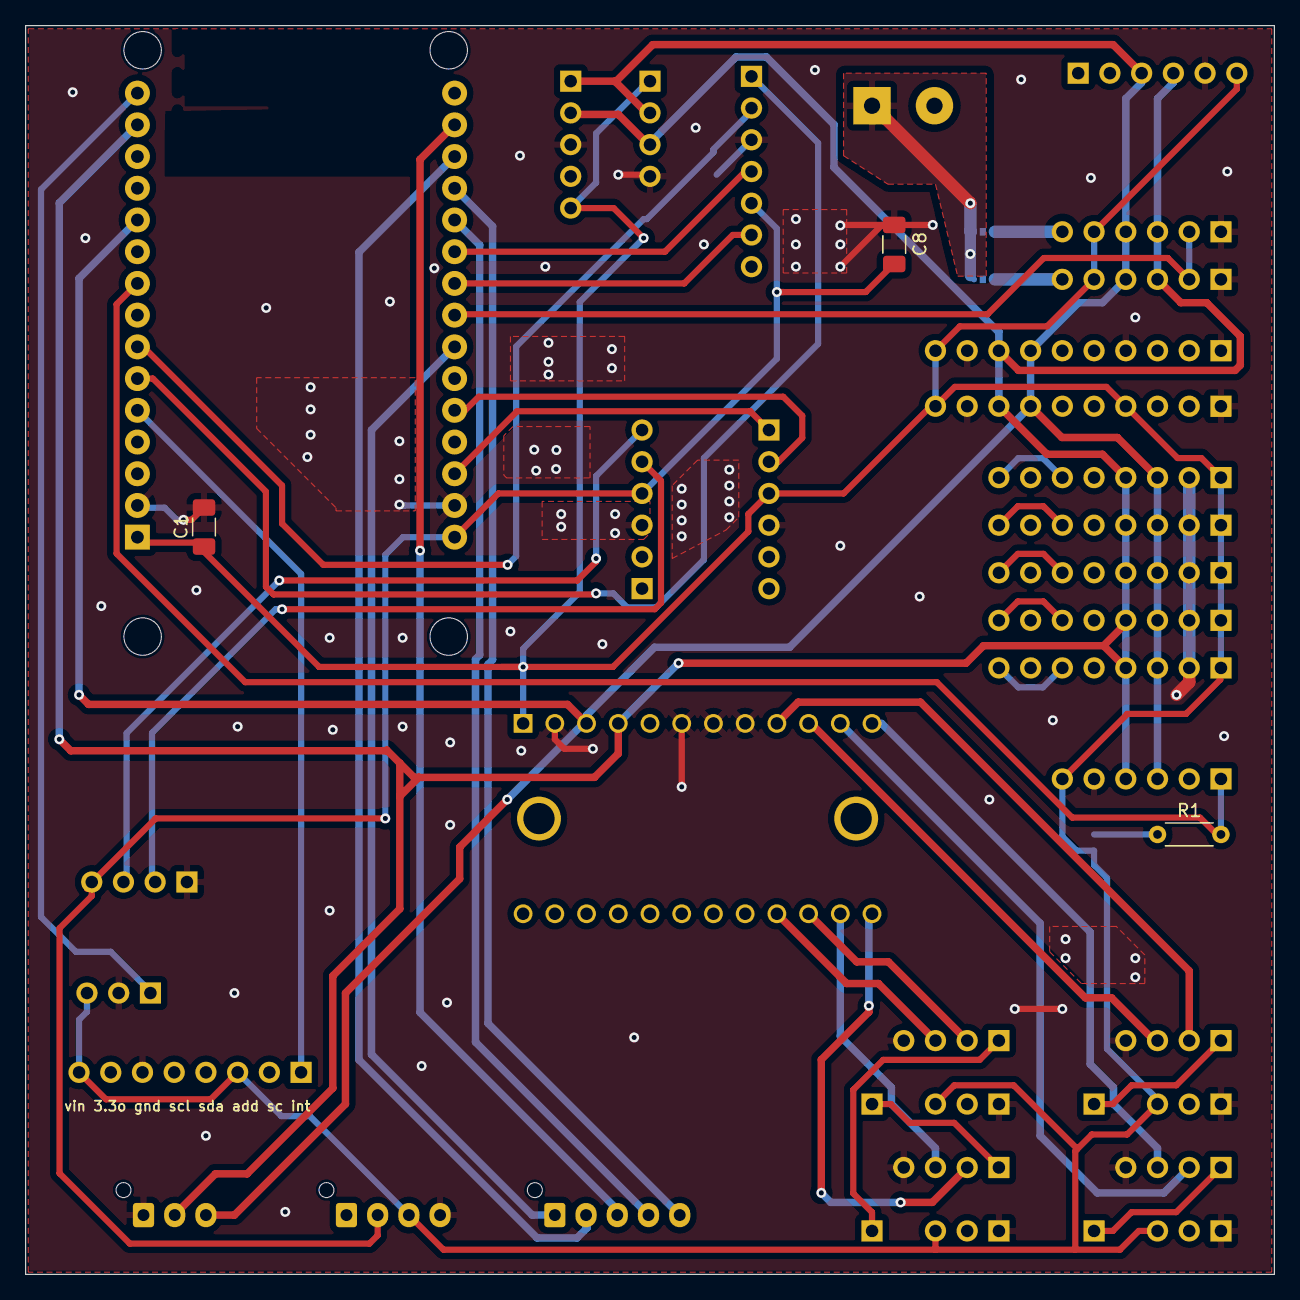
[picture p20: board weerstation-main.kicad_pcb from above]

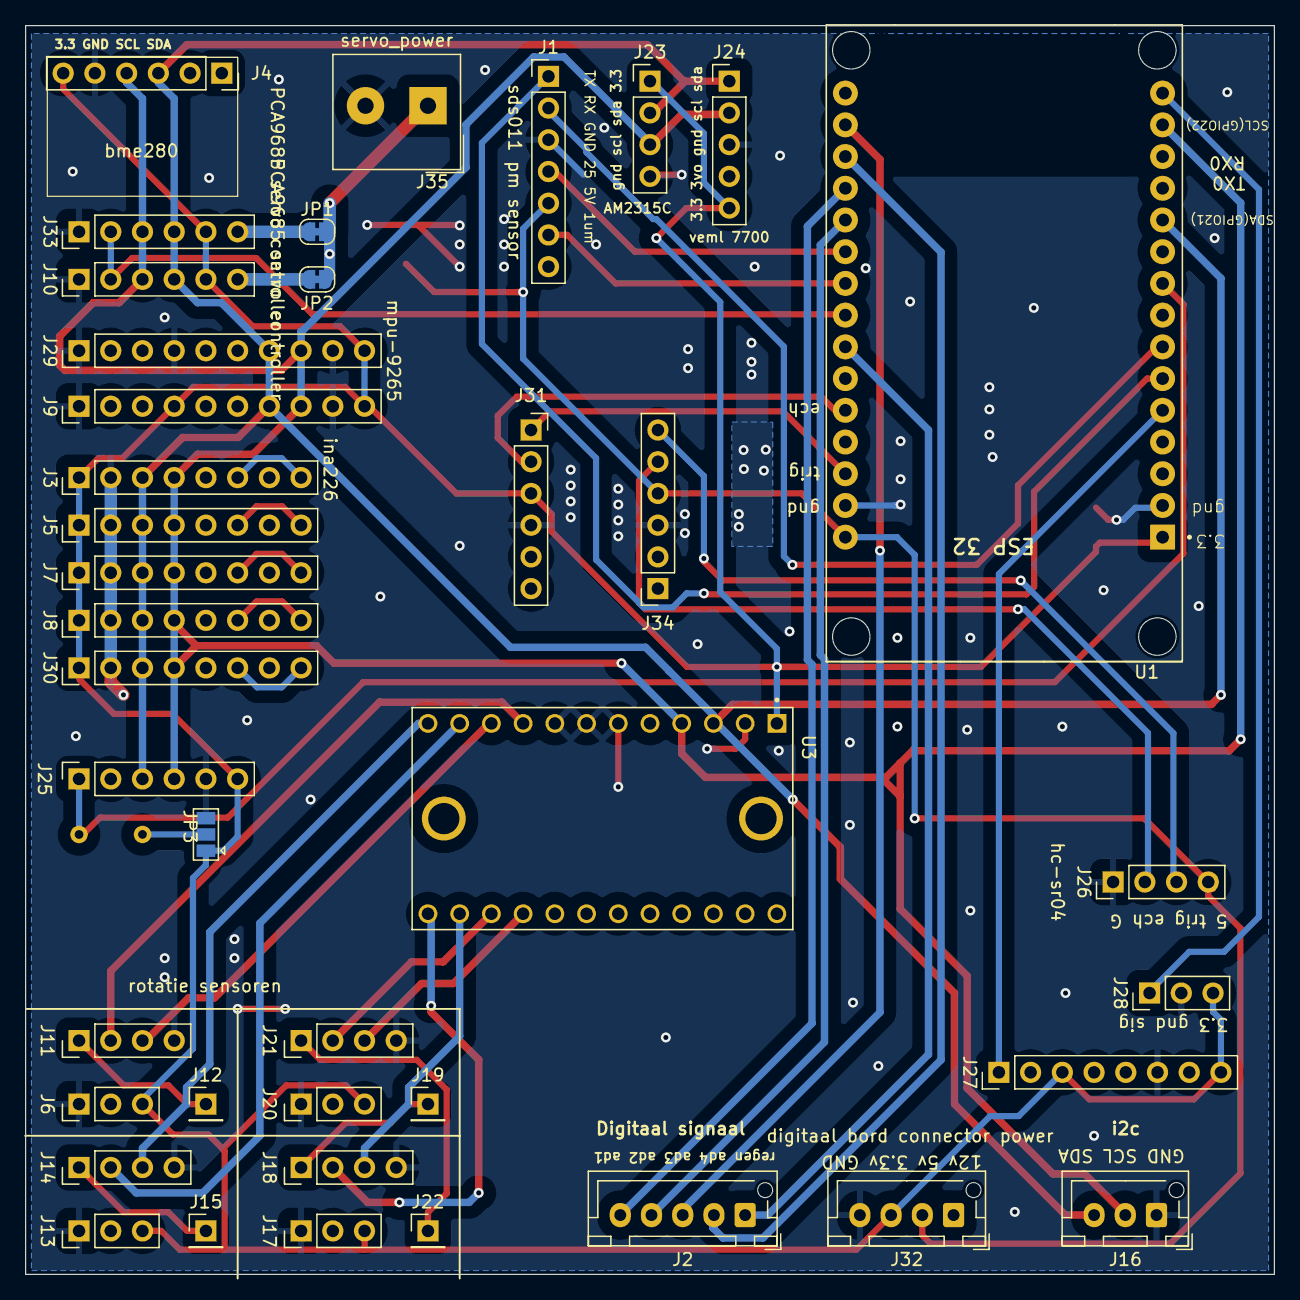
[picture p21: board weerstation-main.kicad_pcb from below]

Board: 2 copper layers, 100.0 x 100.0 mm, 55 parts (40 on the bottom side), 43 nets.
