tjallingk/airostation/pcb-files/analog/weerstation-analoog.kicad_pcb

## KiCad design pcb-files/analog/weerstation-analoog.kicad_pcb (2024-11-19)

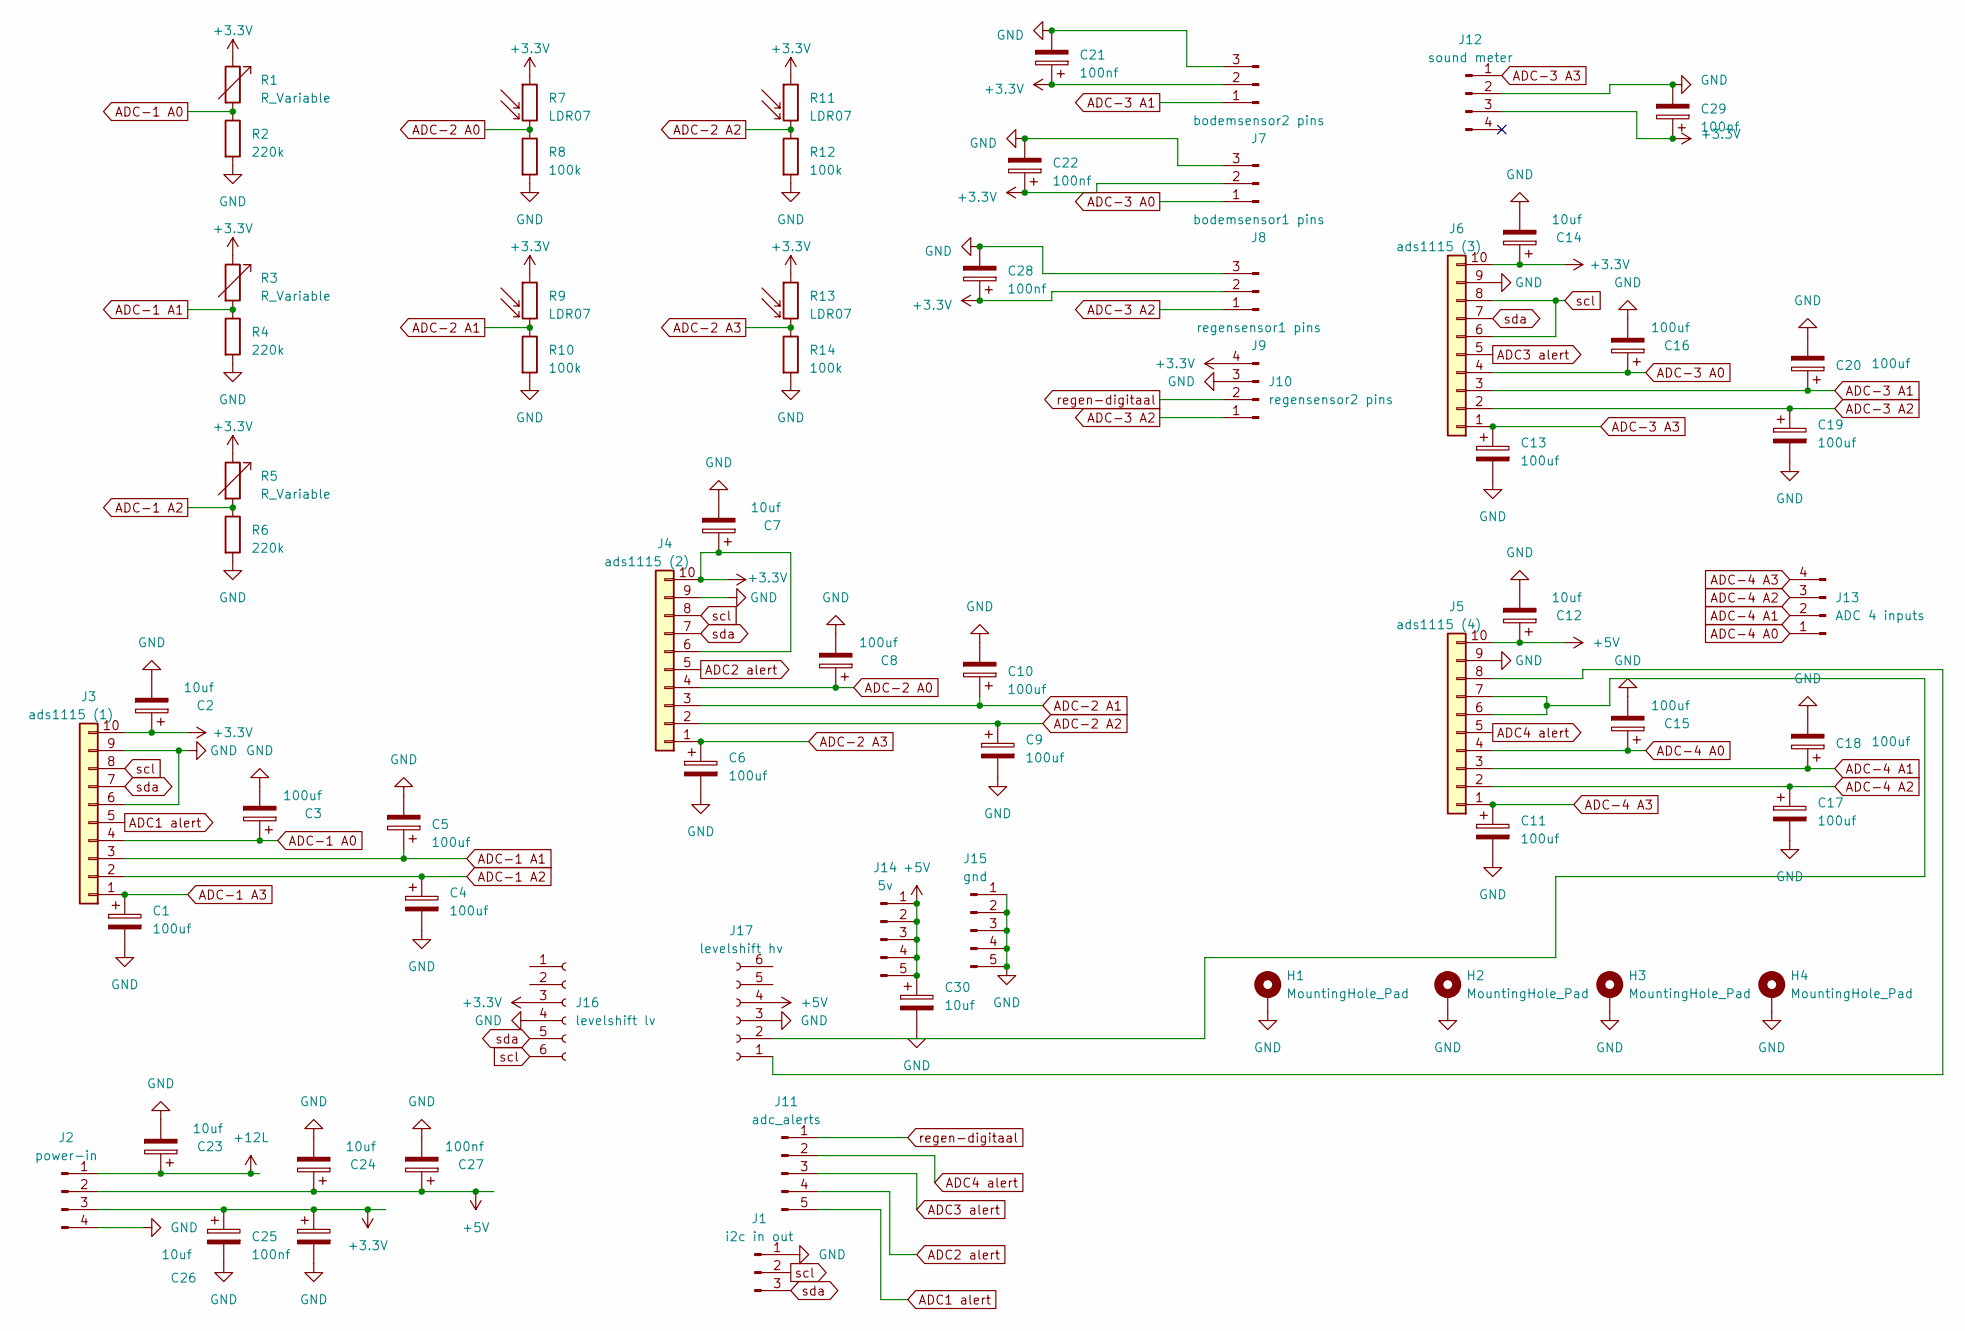
[picture p22: schematic weerstation-analoog.kicad_sch]

Parts:
C1, C3, C4, C5, C6, C8, C9, C10, C11, C13, C15, C16, C17, C18, C19, C20: 100uf; C_1206_3216Metric_Pad1.33x1.80mm_HandSolder
C2, C7, C12, C14, C23, C24, C26, C30: 10uf; C_1206_3216Metric_Pad1.33x1.80mm_HandSolder
C21, C22, C25, C27, C28, C29: 100nf; C_1206_3216Metric_Pad1.33x1.80mm_HandSolder
H1, H2, H3, H4: MountingHole_Pad; MountingHole_2.7mm_M2.5_Pad
J1: i2c in out; JST_XH_B3B-XH-AM_1x03_P2.50mm_Vertical
J2: power-in; JST_XH_B4B-XH-AM_1x04_P2.50mm_Vertical
J3: ads1115 (1); PinSocket_1x10_P2.54mm_Vertical
J4: ads1115 (2); PinSocket_1x10_P2.54mm_Vertical
J5: ads1115 (4); PinSocket_1x10_P2.54mm_Vertical
J6: ads1115 (3); PinSocket_1x10_P2.54mm_Vertical
J7: bodemsensor2 pins; PinHeader_1x03_P2.54mm_Vertical
J8: bodemsensor1 pins; PinHeader_1x03_P2.54mm_Vertical
J9: regensensor1 pins; PinHeader_1x03_P2.54mm_Vertical
J10: regensensor2 pins; PinHeader_1x04_P2.54mm_Vertical
J11: adc_alerts; JST_XH_B5B-XH-AM_1x05_P2.50mm_Vertical
J12: sound meter; PinHeader_1x04_P2.54mm_Vertical
J13: ADC 4 inputs; PinHeader_1x04_P2.54mm_Vertical
J14: 5v; PinHeader_1x05_P2.54mm_Vertical
J15: gnd; PinHeader_1x05_P2.54mm_Vertical
J16: levelshift lv; PinSocket_1x06_P2.54mm_Vertical
J17: levelshift hv; PinSocket_1x06_P2.54mm_Vertical
R1, R3, R5: R_Variable; JST_XH_B2B-XH-AM_1x02_P2.50mm_Vertical
R2, R4, R6: 220k; R_Axial_DIN0204_L3.6mm_D1.6mm_P7.62mm_Horizontal
R7, R9, R11, R13: LDR07; PinHeader_1x02_P2.54mm_Vertical
R8, R10, R12, R14: 100k; R_Axial_DIN0204_L3.6mm_D1.6mm_P7.62mm_Horizontal

Connections:
+3.3V: C2.1, C7.1, C14.1, C21.1, C22.1, C25.1, C26.1, C28.1, C29.1, J2.3, J3.10, J4.6, J4.10, J6.10, J7.2, J8.2, J9.2, J10.4, J12.3, J16.3, R1.1, R3.1, R5.1, R7.1, R9.1, R11.1, R13.1
+5V: C12.1, C24.1, C27.1, C30.1, J2.2, J5.10, J14.1, J14.2, J14.3, J14.4, J14.5, J17.4
+12L: C23.1, J2.1
ADC1 alert: J3.5, J11.5
ADC2 alert: J4.5, J11.4
ADC3 alert: J6.5, J11.3
ADC4 alert: J5.5, J11.2
ADC-1 A0: C3.1, J3.4, R1.2, R2.1
ADC-1 A1: C5.1, J3.3, R3.2, R4.1
ADC-1 A2: C4.1, J3.2, R5.2, R6.1
ADC-1 A3: C1.1, J3.1
ADC-2 A0: C8.1, J4.4, R7.2, R8.1
ADC-2 A1: C10.1, J4.3, R9.2, R10.1
ADC-2 A2: C9.1, J4.2, R11.2, R12.1
ADC-2 A3: C6.1, J4.1, R13.2, R14.1
ADC-3 A0: C16.1, J6.4, J8.1
ADC-3 A1: C20.1, J6.3, J7.1
ADC-3 A2: C19.1, J6.2, J9.1, J10.1
ADC-3 A3: C13.1, J6.1, J12.1
ADC-4 A0: C15.1, J5.4, J13.1
ADC-4 A1: C18.1, J5.3, J13.2
ADC-4 A2: C17.1, J5.2, J13.3
ADC-4 A3: C11.1, J5.1, J13.4
GND: C1.2, C2.2, C3.2, C4.2, C5.2, C6.2, C7.2, C8.2, C9.2, C10.2, C11.2, C12.2, C13.2, C14.2, C15.2, C16.2, C17.2, C18.2, C19.2, C20.2, C21.2, C22.2, C23.2, C24.2, C25.2, C26.2, C27.2, C28.2, C29.2, C30.2, H1.1, H2.1, H3.1, H4.1, J1.1, J2.4, J3.6, J3.9, J4.9, J5.9, J6.9, J7.3, J8.3, J9.3, J10.3, J12.2, J15.1, J15.2, J15.3, J15.4, J15.5, J16.4, J17.3, R2.2, R4.2, R6.2, R8.2, R10.2, R12.2, R14.2
unnamed: J5.8, J17.1
unnamed: J5.6, J5.7, J17.2
regen-digitaal: J10.2, J11.1
scl: J1.2, J3.8, J4.8, J6.6, J6.8, J16.6
sda: J1.3, J3.7, J4.7, J6.7, J16.5
