tjallingk/airostation/pcb-files/analog/weerstation-analoog.kicad_pcb

## KiCad design pcb-files/analog/weerstation-analoog.kicad_pcb (continued)

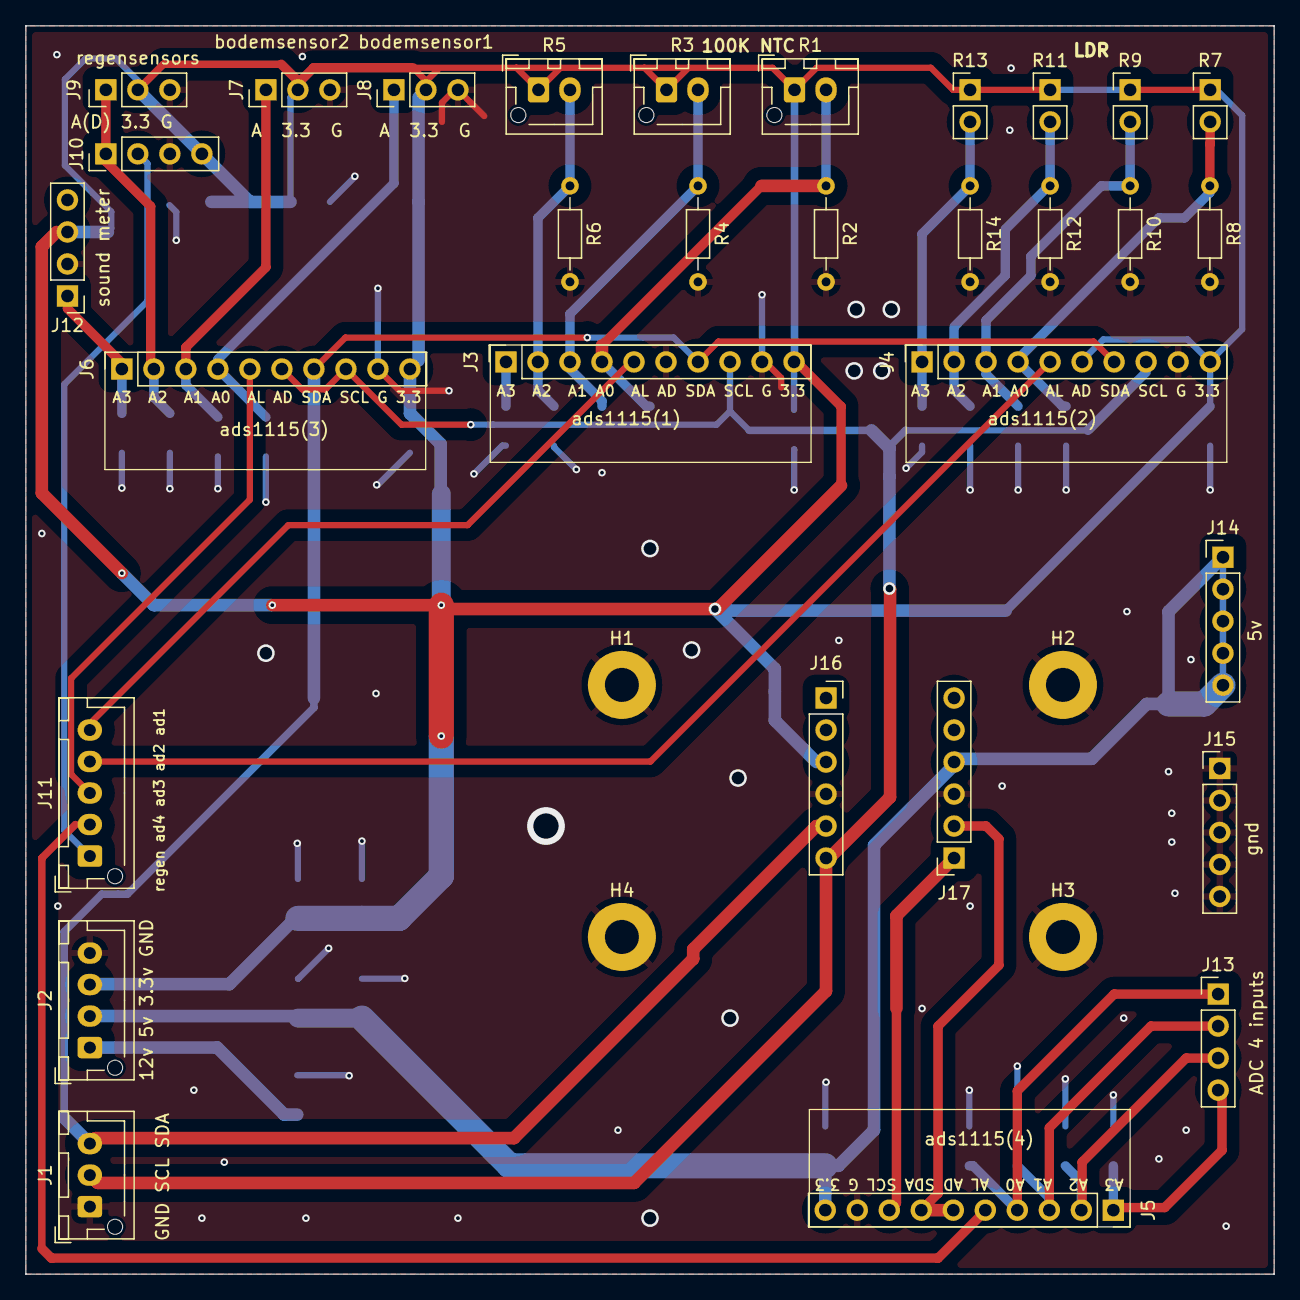
[picture p23: board weerstation-analoog.kicad_pcb from above]

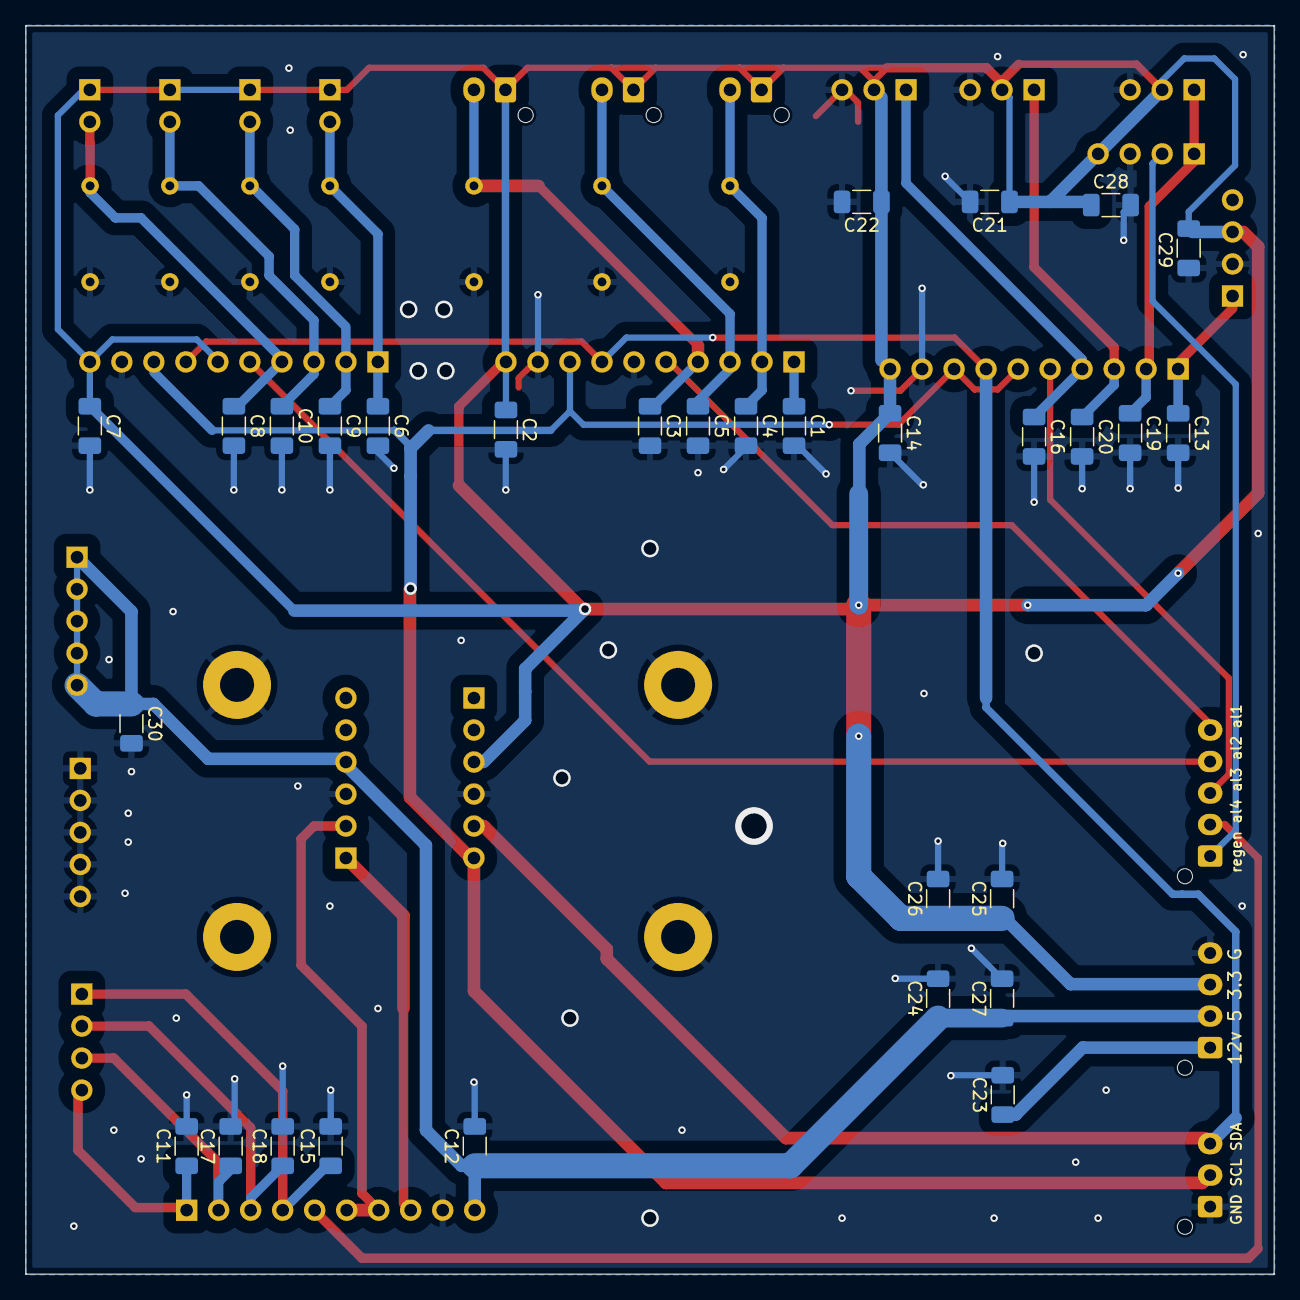
[picture p24: board weerstation-analoog.kicad_pcb from below]

Board: 2 copper layers, 99.1 x 99.1 mm, 65 parts (30 on the bottom side), 29 nets.
