tjallingk/airostation/(commit log)

2024-11-16 v1 pcbs
    3 pcbs with images looking for feedback to get v2 better
    [sensoren list.ods, untitled.kicad_sch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]
2024-11-18 update pcb files better layout and grounding inproved
    [sensoren list.ods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]
2024-11-19 pcbs as orderd. loads of grounding fixes
    [weerstation-analoog-B_Cu.gbr, weerstation-analoog-B_Mask.gbr, weerstation-analoog-B_Paste.gbr, weerstation-analoog-B_Silkscreen.gbr, weerstation-analoog-Edge_Cuts.gbr, weerstation-analoog-F_Cu.gbr, weerstation-analoog-F_Mask.gbr, weerstation-analoog-F_Silkscreen.gbr]
2025-08-27 code update trying mqtt auto discovery.
    added rain meter code cleanup mqtt topics in 1 file add ota and some more sensor stuff
2025-08-28 working auto discovery bug weird readings am2315 and aht21
    some bugs with reading weird temps and the 2 0x38 adress sensors also possible issue ota updates? but since upping buffer for mqtt the auto discovery topic stuff works great
    [mqtt-topics.h, mqtt-v2.ino, networking.cpp, sensors.cpp]
